xL1n/MOSBius_V2_PCB/README.md

MOSBius V2 PCB Design 
Contains Mother Board & Daughter Board
