xL1n/MOSBius_V2_PCB/MOSbiusPCB_v3b_2025 (pcbway fab correct schematic)/3D/Screenshot 2025-02-14 at 1.38.24 PM.png

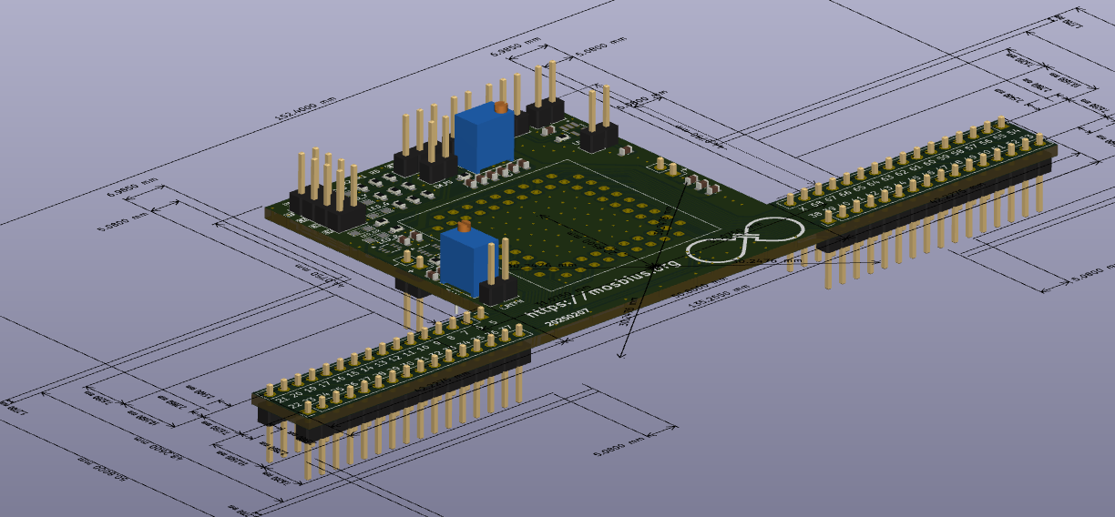
MOSbiusPCB_v3b_2025 (pcbway fab correct schematic)/3D/Screenshot 2025-02-14 at 1.38.24 PM.png
