xL1n/MOSBius_V2_PCB/3314_SMD_25kPOT/3314J-1-253E.step

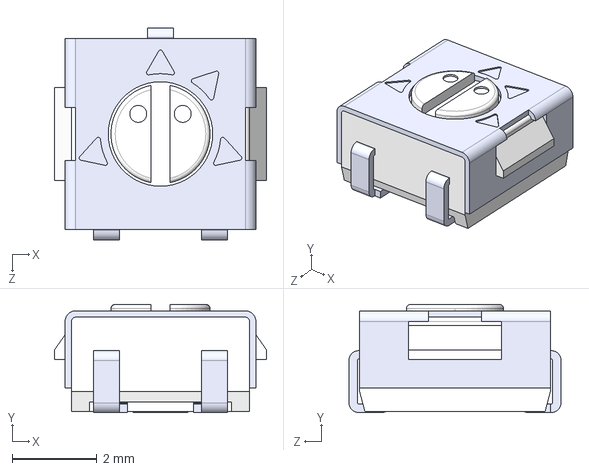
[picture p4: CAD file, 2026-03-12]
3314_SMD_25kPOT/3314J-1-253E.step
5.00 x 2.55 x 5.00 mm
