xL1n/MOSBius_V2_PCB/AD8542ARMZ-REEL/3D/AD8542ARMZ-REEL.stp

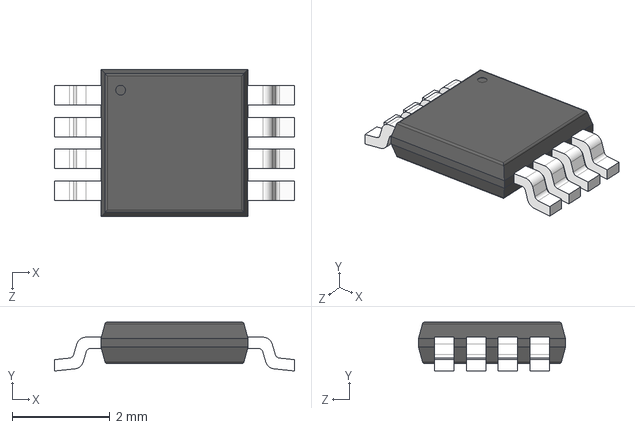
[picture p5: CAD file, 2025-09-01]
AD8542ARMZ-REEL/3D/AD8542ARMZ-REEL.stp
4.90 x 1.00 x 3.00 mm
