xL1n/MOSBius_V2_PCB/combined_board_RPI_pico/combined_board_RPI_pico.step

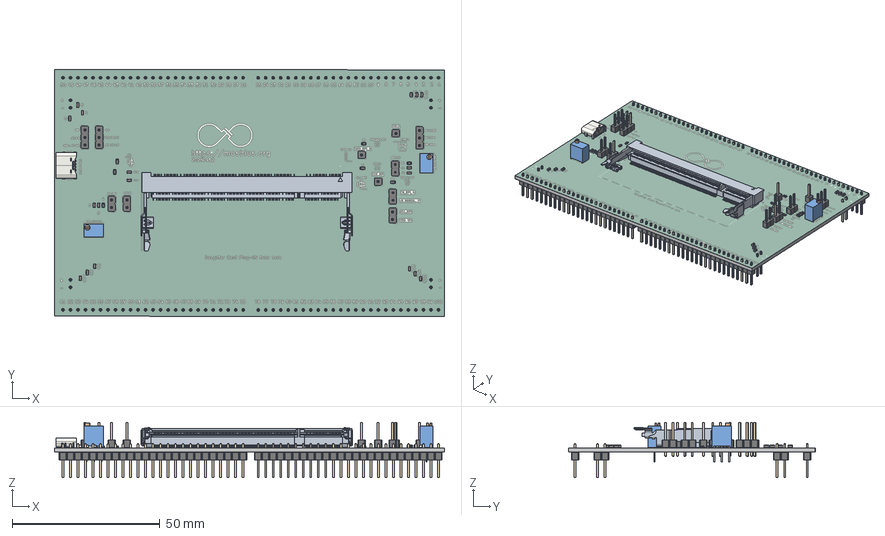
[picture p6: CAD file, 2025-10-16]
combined_board_RPI_pico/combined_board_RPI_pico.step
131.9 x 83.5 x 18.8 mm
R_0603_1608Metric x 7
C_0603_1608Metric x 18
PinHeader_1x03_P2.54mm_Vertical x 3
PinHeader_1x01_P2.54mm_Vertical x 3
PinHeader_1x02_P2.54mm_Vertical x 8
Potentiometer_Bourns_3266Y_Vertical x 2
USB_C_Receptacle_GCT_USB4125-xx-x_6P_TopMnt_Horizontal
PinHeader_1x25_P2.54mm_Vertical x 4
Mother_Card_silkscreen
Mother_Card_soldermask
Mother_Card_PCB
