xL1n/MOSBius_V2_PCB/DS4404_DAC/DS4404N__T_R.step

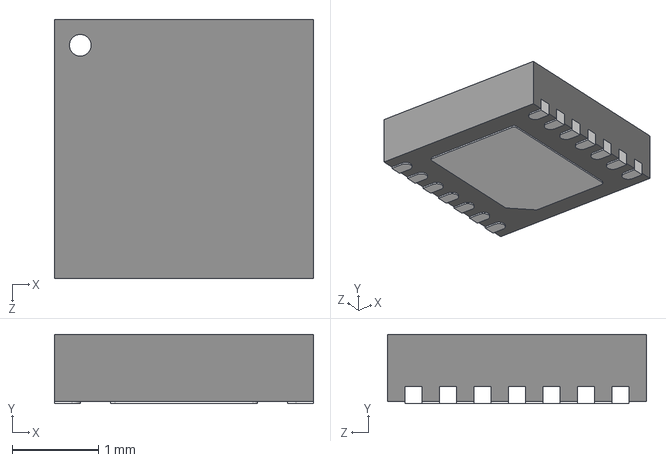
[picture p7: CAD file, 2026-03-12]
DS4404_DAC/DS4404N__T_R.step
3.00 x 0.8 x 3.00 mm
