xL1n/MOSBius_V2_PCB/LTC4365HTS8#PBF/3D/LTC4365HTS8#PBF.stp

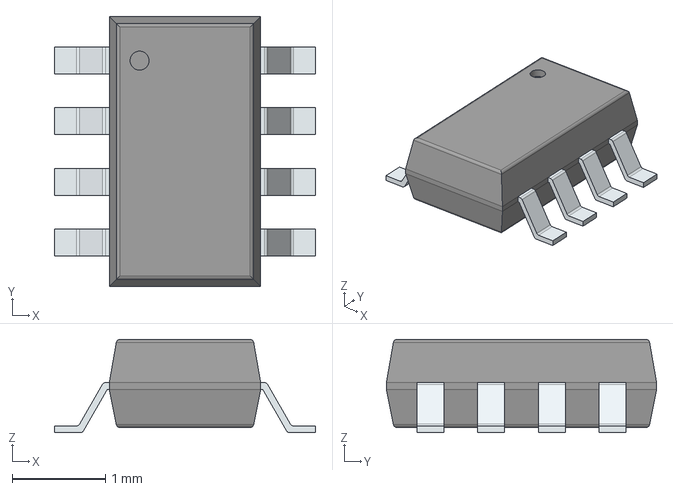
[picture p8: CAD file, 2025-09-01]
LTC4365HTS8#PBF/3D/LTC4365HTS8#PBF.stp
2.80 x 2.90 x 1.00 mm
PinsArrayLR
