xL1n/MOSBius_V2_PCB/MOSbiusPCB_v3b_2025 (pcbway fab correct schematic)/MOSbiusPCB_v3b_2024.step

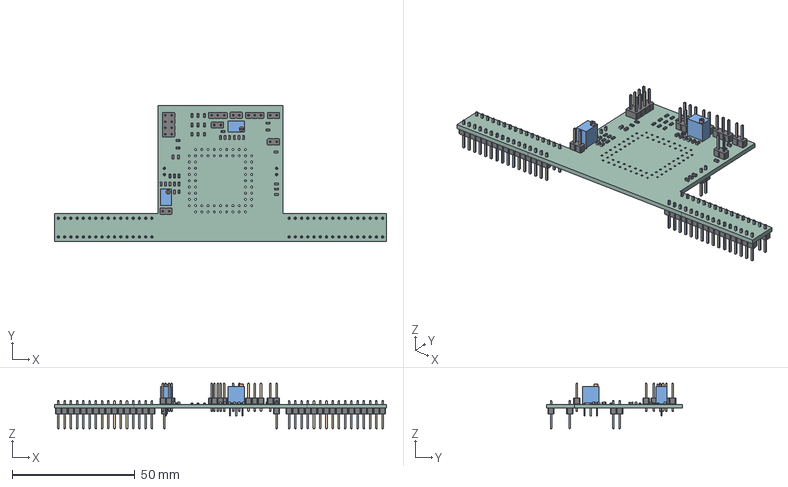
[picture p9: CAD file, 2025-09-01]
MOSbiusPCB_v3b_2025 (pcbway fab correct schematic)/MOSbiusPCB_v3b_2024.step
135.3 x 55.5 x 18.6 mm
C_0603_1608Metric x 18
PinHeader_1x02_P254mm_Vertical x 7
R_0603_1608Metric x 18
Potentiometer_Bourns_3266Y_Vertical x 2
PinHeader_1x16_P254mm_Vertical x 4
PinHeader_1x03_P254mm_Vertical x 2
PinHeader_2x04_P254mm_Vertical
MOSbiusPCB_v3b_2024_PCB
