xL1n/MOSBius_V2_PCB/NCV8164ASN250T1G/3D/NCV8164ASN250T1G.stp

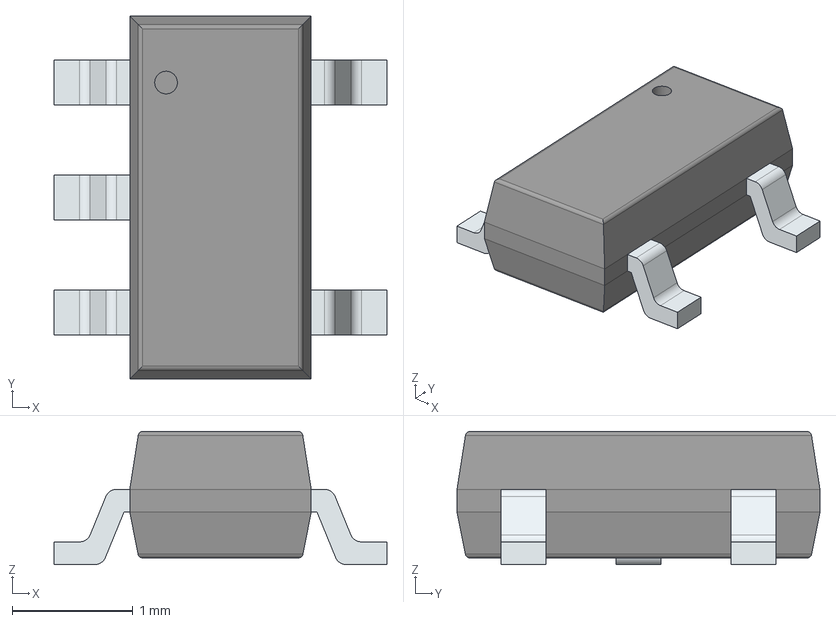
[picture p10: CAD file, 2025-09-01]
NCV8164ASN250T1G/3D/NCV8164ASN250T1G.stp
2.75 x 3.00 x 1.10 mm
PinsArrayL
PinsArrayR
