xL1n/MOSBius_V2_PCB/SN74LVC1G3157DBVR/3D/SN74LVC1G3157DBVR.stp

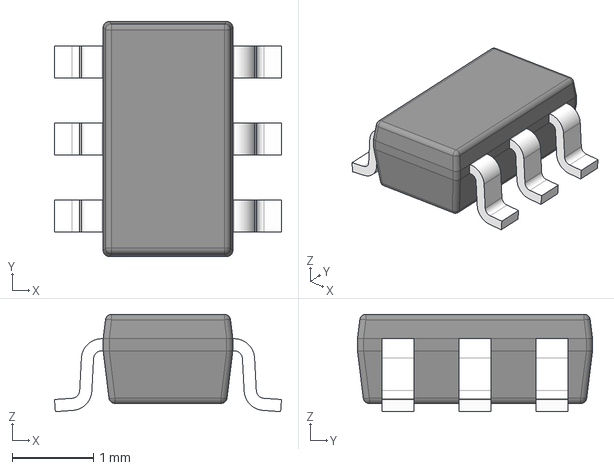
[picture p11: CAD file, 2025-09-01]
SN74LVC1G3157DBVR/3D/SN74LVC1G3157DBVR.stp
2.80 x 2.90 x 1.20 mm
BODY-SOT
LEAD-SOT x 6
