xL1n/MOSBius_V2_PCB/SN74LVC2G241DCUR/3D/SN74LVC2G241DCUR.stp

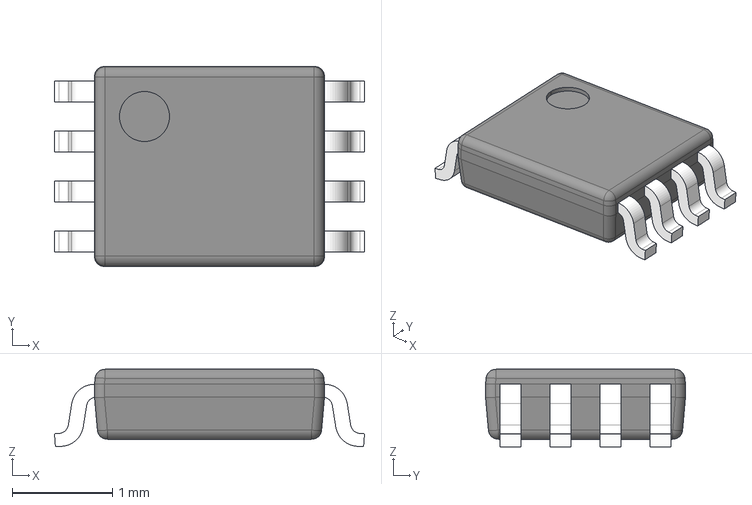
[picture p12: CAD file, 2025-09-01]
SN74LVC2G241DCUR/3D/SN74LVC2G241DCUR.stp
3.10 x 2.00 x 0.775 mm
BODY-VSSOP
LEAD-VSSOP x 8
