xL1n/MOSBius_V2_PCB/UM6K34NTCN/3D/UM6K34NTCN.stp

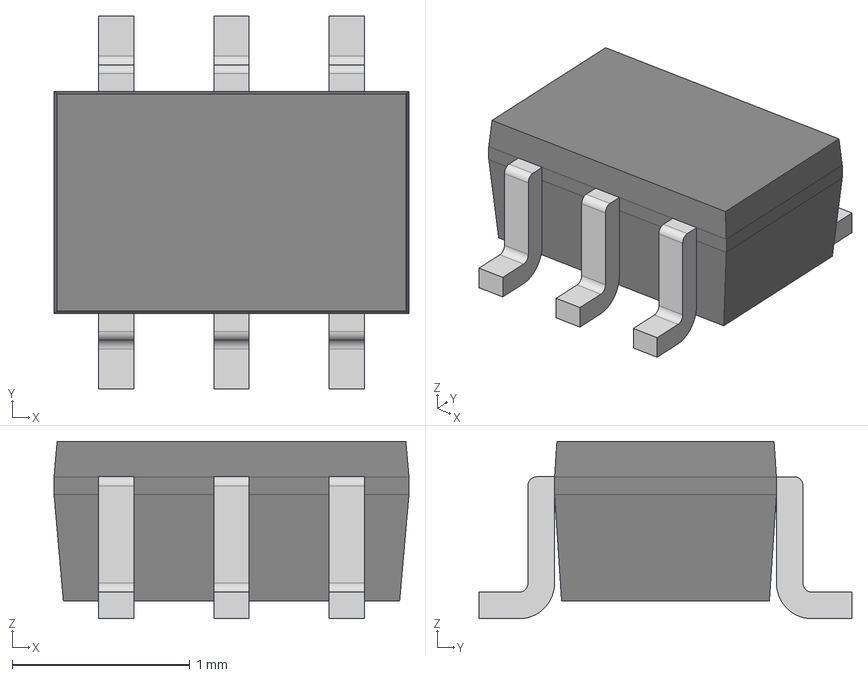
[picture p13: CAD file, 2025-09-01]
UM6K34NTCN/3D/UM6K34NTCN.stp
2.00 x 2.10 x 1 mm
3D_Model_UMT6-prt0
3D_Model_UMT6-prt1
3D_Model_UMT6-prt2
3D_Model_UMT6-prt3
3D_Model_UMT6-prt4
3D_Model_UMT6-prt5
3D_Model_UMT6-prt6
