xL1n/MOSBius_V2_PCB/(list of files, cad)

Other CAD files:
AD8542ARMZ-REEL/Allegro/sop65p490x110-8n.psm
AD8542ARMZ-REEL/DEHDL/ad8542armz_reel/chips/chips.prt
KiCad-RP-Pico-main/SketchUp Model/Pico.skp
LTC4365HTS8#PBF/Allegro/sot65p280x100-8n.psm
LTC4365HTS8#PBF/DEHDL/ltc4365hts8#pbf/chips/chips.prt
MOSbiusPCB_v3b_2025 (pcbway fab correct schematic)/MOSbiusPCB_v3b_2024.stl
NCV8164ASN250T1G/Allegro/sot95p275x110-5n.psm
NCV8164ASN250T1G/DEHDL/ncv8164asn250t1g/chips/chips.prt
SN74LVC1G3157DBVR/Allegro/sot95p280x145-6n.psm
SN74LVC1G3157DBVR/DEHDL/sn74lvc1g3157dbvr/chips/chips.prt
SN74LVC2G241DCUR/Allegro/sop50p310x90-8n.psm
SN74LVC2G241DCUR/DEHDL/sn74lvc2g241dcur/chips/chips.prt
SN74LVC2G34DBVR/Allegro/sot95p280x145-6n.psm
SN74LVC2G34DBVR/DEHDL/sn74lvc2g34dbvr/chips/chips.prt
SODIIMM_200_Socket/Allegro/517465304.psm
SODIIMM_200_Socket/DEHDL/5_1746530_4/chips/chips.prt
UM6K34NTCN/Allegro/sot65p210x100-6n.psm
UM6K34NTCN/DEHDL/um6k34ntcn/chips/chips.prt
