xL1n/MOSBius_V2_PCB/(list of files, drawings)

Other design files:
AD8542ARMZ-REEL/Altium/AD8542ARMZ-REEL.SchLib
AD8542ARMZ-REEL/Altium/SOP65P490X110-8N.PcbLib
LTC4365HTS8#PBF/Altium/LTC4365HTS8#PBF.SchLib
LTC4365HTS8#PBF/Altium/SOT65P280X100-8N.PcbLib
MOSbius_V2_Test/V2_TST/freerouting.dsn
MOSbius_V2_Test/V2_TST/temp-freerouting.dsn
NCV8164ASN250T1G/Altium/NCV8164ASN250T1G.SchLib
NCV8164ASN250T1G/Altium/SOT95P275X110-5N.PcbLib
SN74LVC1G3157DBVR/Altium/SN74LVC1G3157DBVR.SchLib
SN74LVC1G3157DBVR/Altium/SOT95P280X145-6N.PcbLib
SN74LVC2G34DBVR/Altium/SN74LVC2G34DBVR.SchLib
SN74LVC2G34DBVR/Altium/SOT95P280X145-6N.PcbLib
SN74LVC2G241DCUR/Altium/SN74LVC2G241DCUR.SchLib
SN74LVC2G241DCUR/Altium/SOP50P310X90-8N.PcbLib
SODIIMM_200_Socket/Altium/5-1746530-4.SchLib
SODIIMM_200_Socket/Altium/517465304.PcbLib
UM6K34NTCN/Altium/SOT65P210X100-6N.PcbLib
UM6K34NTCN/Altium/UM6K34NTCN.SchLib
