xL1n/MOSBius_V2_PCB/combined_board/combined_board.kicad_pcb

## KiCad design combined_board/combined_board.kicad_pcb (2026-03-12)

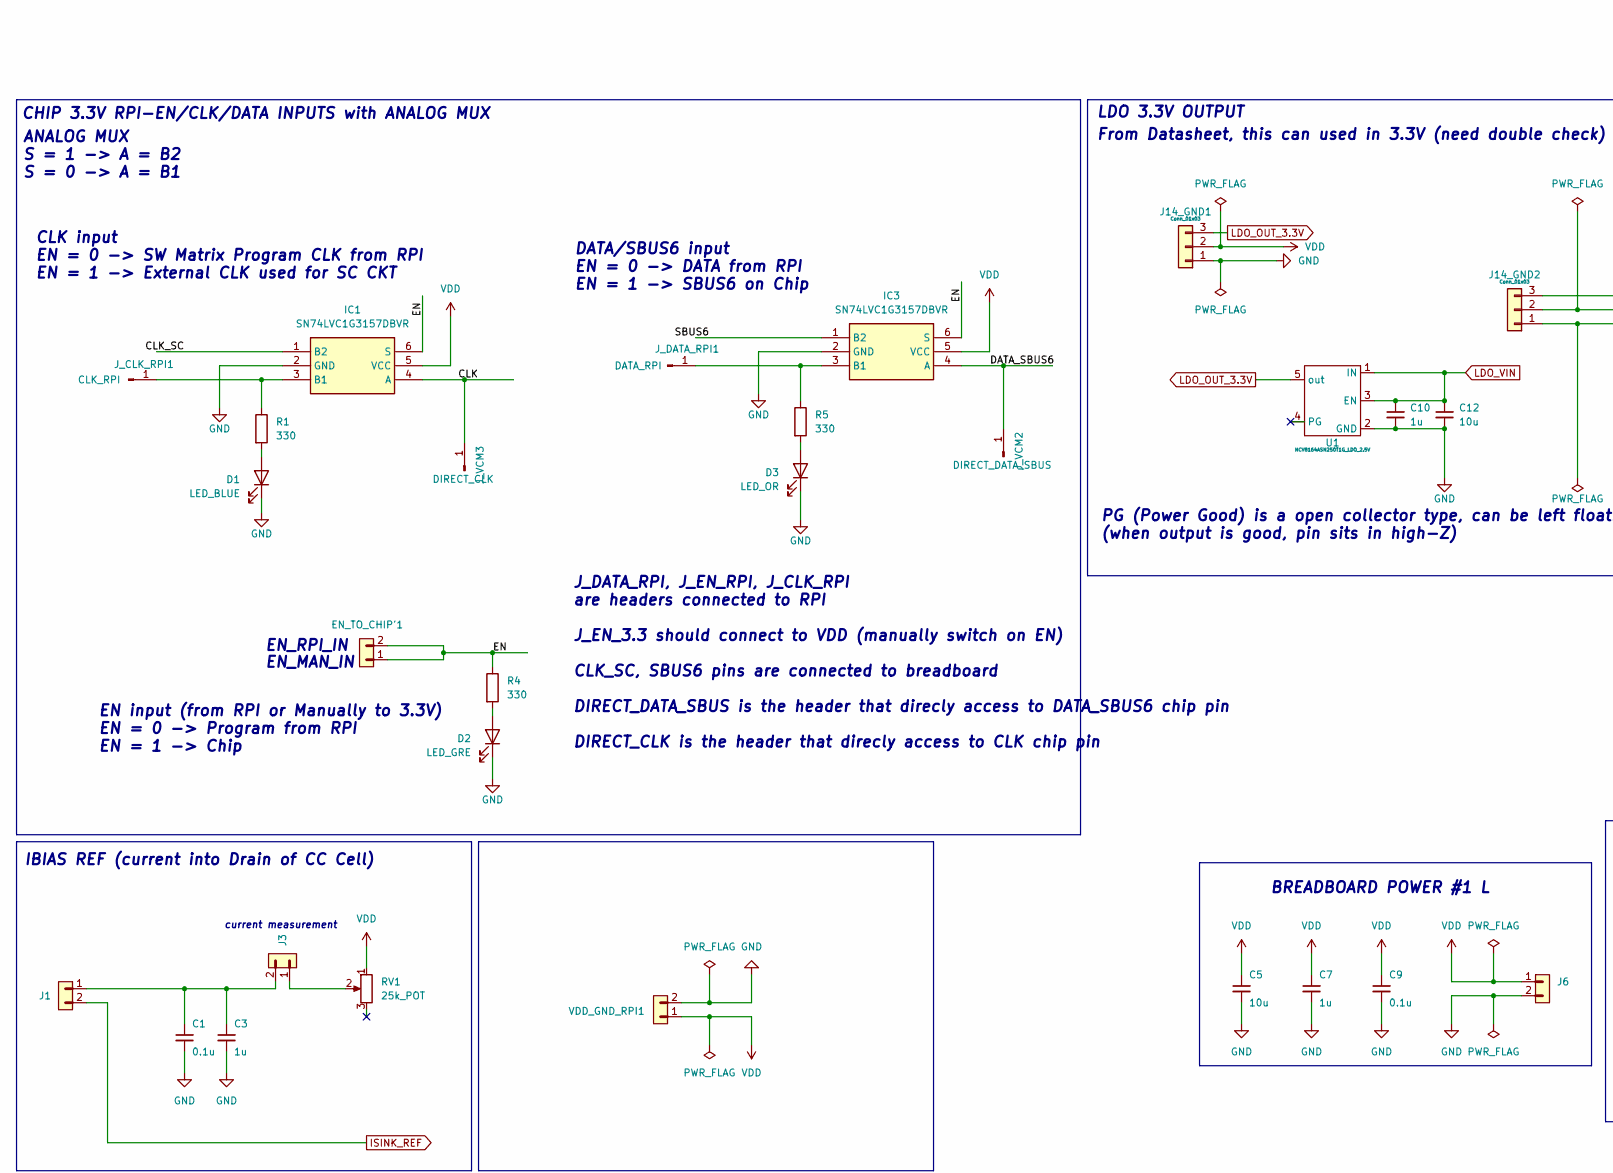
[picture p27: schematic combined_board.kicad_sch, MOSBius_V2 PCB Mother Card Schematic, part in row 1, column 1]

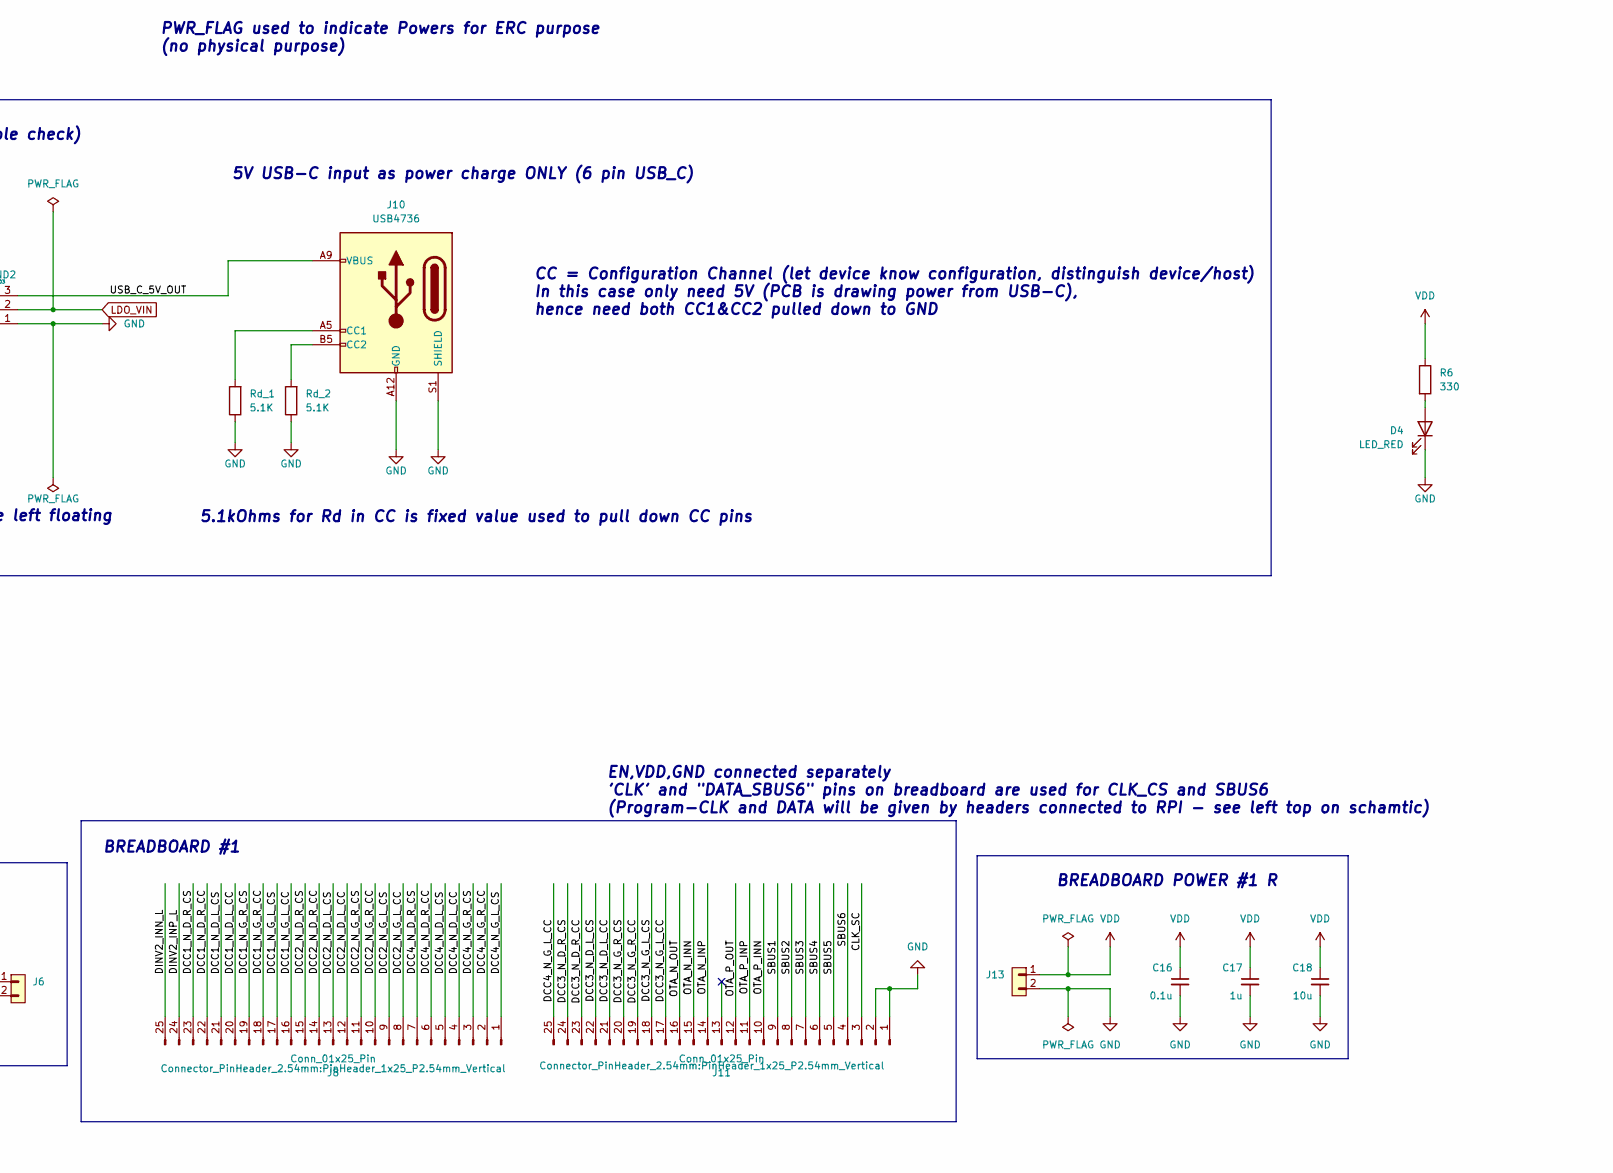
[picture p28: schematic combined_board.kicad_sch, MOSBius_V2 PCB Mother Card Schematic, part in row 1, column 2]

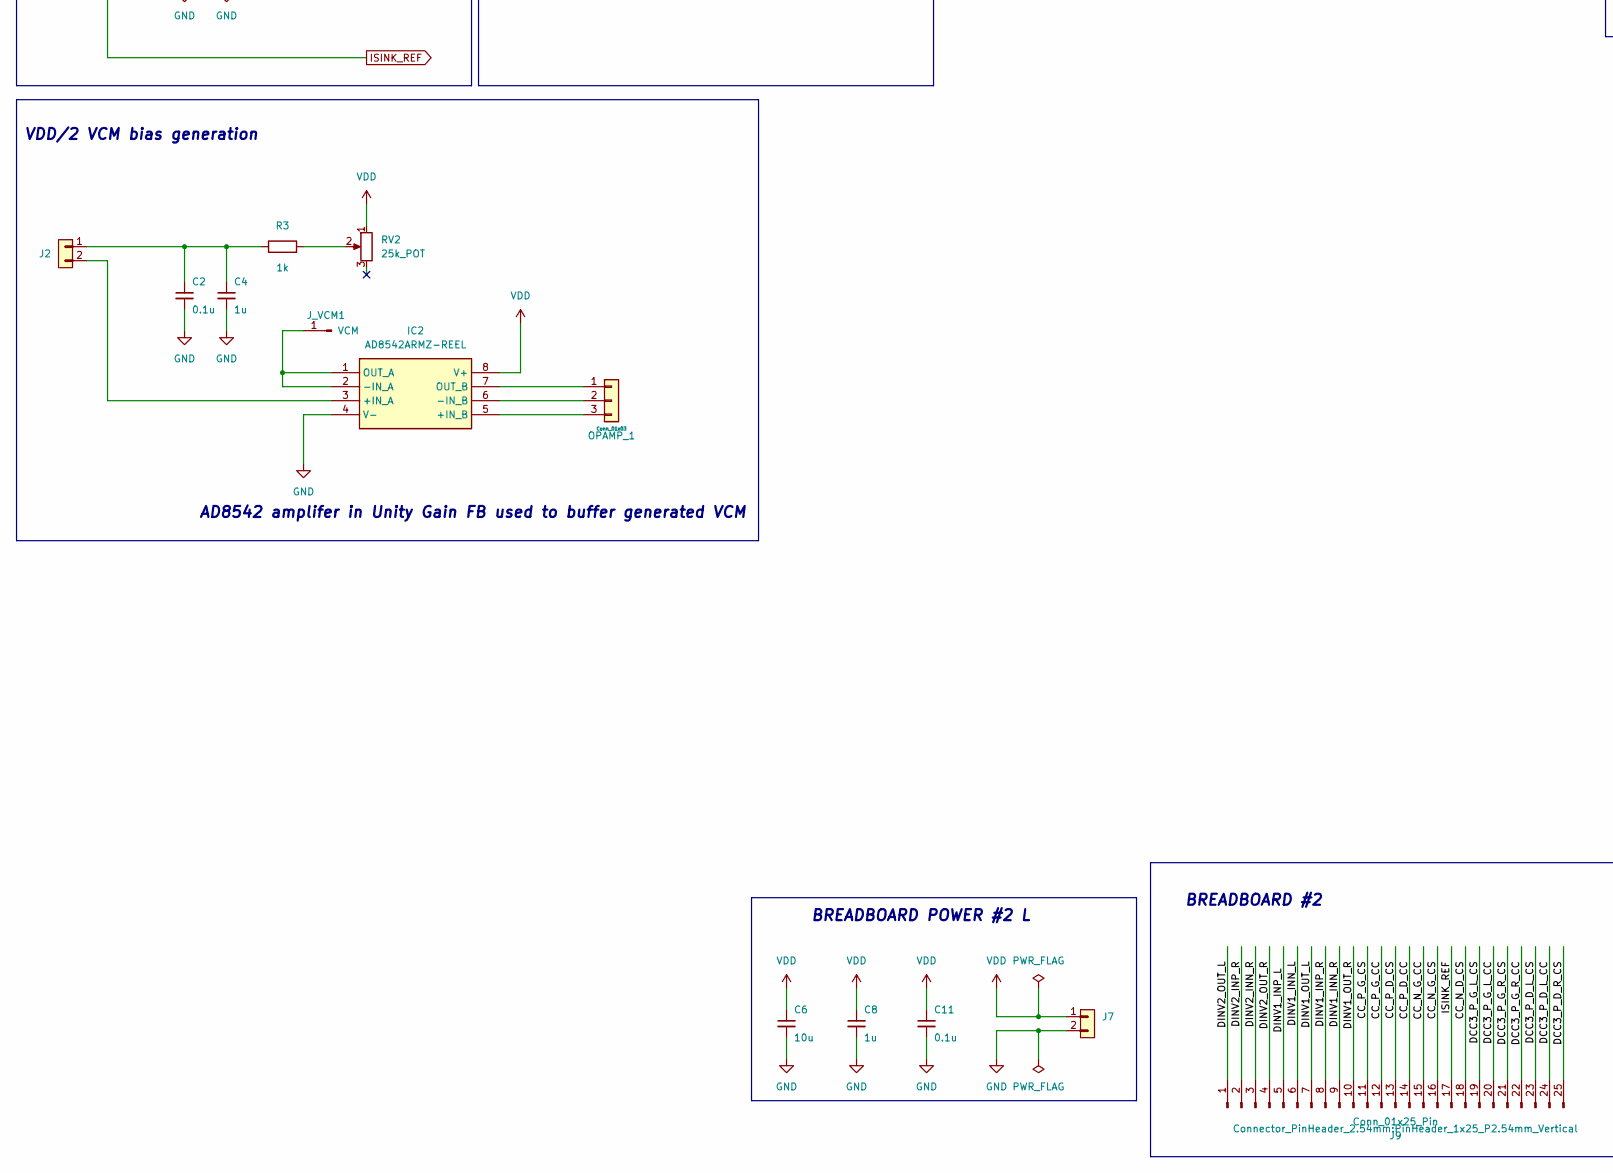
[picture p29: schematic combined_board.kicad_sch, MOSBius_V2 PCB Mother Card Schematic, part in row 2, column 1]

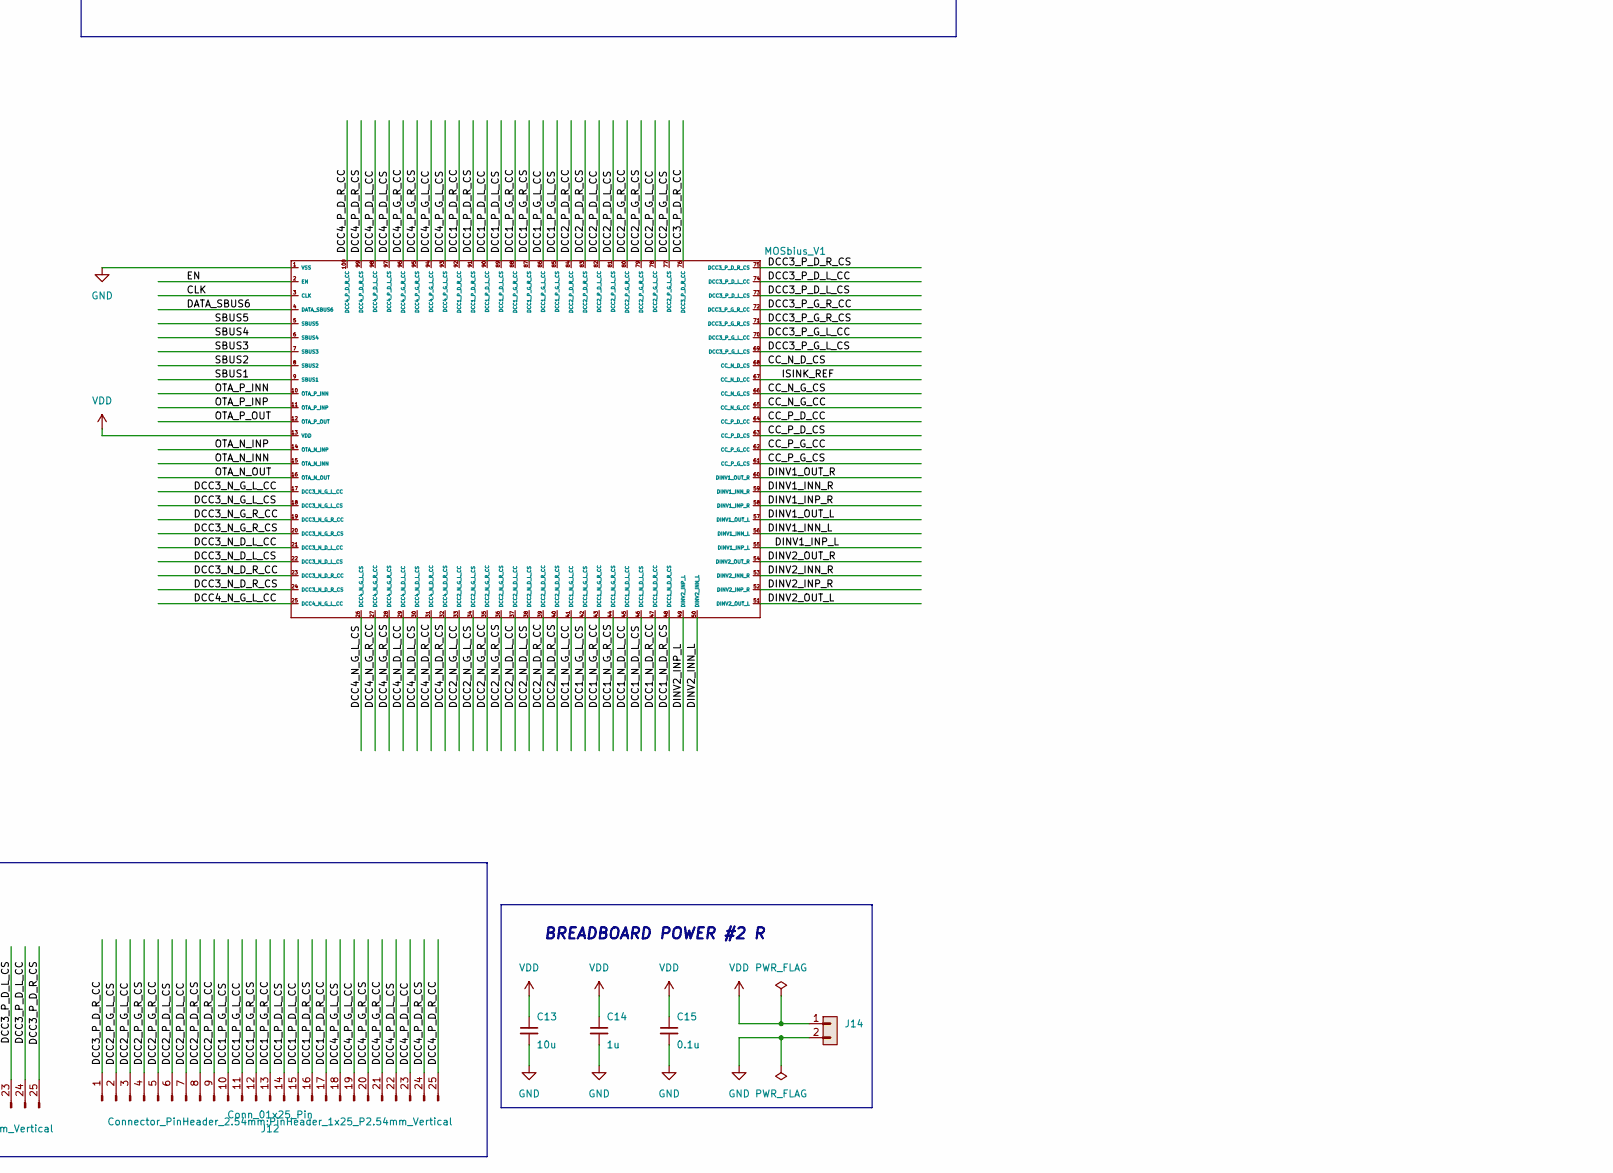
[picture p30: schematic combined_board.kicad_sch, MOSBius_V2 PCB Mother Card Schematic, part in row 2, column 2]

Parts:
C1, C2, C9, C11, C15, C16: 0.1u; C_0603_1608Metric
C3, C4, C7, C8, C10, C14, C17: 1u; C_0603_1608Metric
C5, C6, C12, C13, C18: 10u; C_0603_1608Metric
D1: LED_BLUE; LED_150120RS75000_WRE
D2: LED_GRE; LED_150120RS75000_WRE
D3: LED_OR; LED_150120RS75000_WRE
D4: LED_RED; LED_150120RS75000_WRE
EN_TO_CHIP'1: PINHD_1x2_Male; PinHeader_1x02_P2.54mm_Vertical
IC1, IC3: SN74LVC1G3157DBVR; SN74LVC1G3157; Manufacturer_Part_Number SN74LVC1G3157DBVR; Mouser Part Number 595-SN74LVC1G3157DBV
IC2: AD8542ARMZ-REEL; AD8542; Manufacturer_Part_Number AD8542ARMZ-REEL; Mouser Part Number 584-AD8542ARMZ-R
J1, J2, J3, J6, J7, J14: PINHD_1x2_Male; PinHeader_1x02_P2.54mm_Vertical
J8, J9, J11, J12: Conn_01x25_Pin; PinHeader_1x25_P2.54mm_Vertical
J10: USB4736; USB_C_Receptacle_GCT_USB4125-xx-x_6P_TopMnt_Horizontal
J13: Conn_01x02_Pin; PinHeader_1x02_P2.54mm_Vertical
J14_GND1, J14_GND2: Conn_01x03; PinHeader_1x03_P2.54mm_Vertical
J_CLK_RPI1: CLK_RPI; PinHeader_1x01_P2.54mm_Vertical
J_DATA_RPI1: DATA_RPI; PinHeader_1x01_P2.54mm_Vertical
J_VCM1: VCM; PinHeader_1x01_P2.54mm_Vertical
J_VCM2: DIRECT_DATA_SBUS; PinHeader_1x01_P2.54mm_Vertical
J_VCM3: DIRECT_CLK; PinHeader_1x01_P2.54mm_Vertical
MOSbius_V1: MOSbius_V2; ArtInChip_QFN-100-1EP_12x12mm_P0.4mm_EP7.4x7.4mm
OPAMP_1: Conn_01x03; PinHeader_1x03_P2.54mm_Vertical
R1, R4, R5, R6: 330; R_0603_1608Metric
R3: 1k; R_0603_1608Metric
RV1, RV2: 25k_POT; Potentiometer_Bourns_3266Y_Vertical
Rd_1, Rd_2: 5.1K; R_0603_1608Metric
U1: NCV8164ASN250T1G_LDO_2.5V; NCV8164ASN250T1G_LDO
VDD_GND_RPI1: PINHD_1x2_Male; PinHeader_1x02_P2.54mm_Vertical

Connections:
/CC_N_D_CS: J9.18, MOSbius_V1.68 (CC_N_D_CS); also elsewhere on the board
/CC_N_G_CC: J9.15, MOSbius_V1.65 (CC_N_G_CC); also elsewhere on the board
/CC_N_G_CS: J9.16, MOSbius_V1.66 (CC_N_G_CS); also elsewhere on the board
/CC_P_D_CC: J9.14, MOSbius_V1.64 (CC_P_D_CC); also elsewhere on the board
/CC_P_D_CS: J9.13, MOSbius_V1.63 (CC_P_D_CS); also elsewhere on the board
/CC_P_G_CC: J9.12, MOSbius_V1.62 (CC_P_G_CC); also elsewhere on the board
/CC_P_G_CS: J9.11, MOSbius_V1.61 (CC_P_G_CS); also elsewhere on the board
/CLK: IC1.4 (A), J_VCM3.1, MOSbius_V1.3 (CLK); also elsewhere on the board
/CLK_SC: IC1.1 (B2), J11.3
/DATA_SBUS6: IC3.4 (A), J_VCM2.1, MOSbius_V1.4 (DATA_SBUS6); also elsewhere on the board
/DCC1_N_D_L_CC: J8.20, MOSbius_V1.45 (DCC1_N_D_L_CC); also elsewhere on the board
/DCC1_N_D_L_CS: J8.21, MOSbius_V1.46 (DCC1_N_D_L_CS); also elsewhere on the board
/DCC1_N_D_R_CC: J8.22, MOSbius_V1.47 (DCC1_N_D_R_CC); also elsewhere on the board
/DCC1_N_D_R_CS: J8.23, MOSbius_V1.48 (DCC1_N_D_R_CS); also elsewhere on the board
/DCC1_N_G_L_CC: J8.16, MOSbius_V1.41 (DCC1_N_G_L_CC); also elsewhere on the board
/DCC1_N_G_L_CS: J8.17, MOSbius_V1.42 (DCC1_N_G_L_CS); also elsewhere on the board
/DCC1_N_G_R_CC: J8.18, MOSbius_V1.43 (DCC1_N_G_R_CC); also elsewhere on the board
/DCC1_N_G_R_CS: J8.19, MOSbius_V1.44 (DCC1_N_G_R_CS); also elsewhere on the board
/DCC1_P_D_L_CC: J12.15, MOSbius_V1.90 (DCC1_P_D_L_CC); also elsewhere on the board
/DCC1_P_D_L_CS: J12.14, MOSbius_V1.89 (DCC1_P_D_L_CS); also elsewhere on the board
/DCC1_P_D_R_CC: J12.17, MOSbius_V1.92 (DCC1_P_D_R_CC); also elsewhere on the board
/DCC1_P_D_R_CS: J12.16, MOSbius_V1.91 (DCC1_P_D_R_CS); also elsewhere on the board
/DCC1_P_G_L_CC: J12.11, MOSbius_V1.86 (DCC1_P_G_L_CC); also elsewhere on the board
/DCC1_P_G_L_CS: J12.10, MOSbius_V1.85 (DCC1_P_G_L_CS); also elsewhere on the board
/DCC1_P_G_R_CC: J12.13, MOSbius_V1.88 (DCC1_P_G_R_CC); also elsewhere on the board
/DCC1_P_G_R_CS: J12.12, MOSbius_V1.87 (DCC1_P_G_R_CS); also elsewhere on the board
/DCC2_N_D_L_CC: J8.12, MOSbius_V1.37 (DCC2_N_D_L_CC); also elsewhere on the board
/DCC2_N_D_L_CS: J8.13, MOSbius_V1.38 (DCC2_N_D_L_CS); also elsewhere on the board
/DCC2_N_D_R_CC: J8.14, MOSbius_V1.39 (DCC2_N_D_R_CC); also elsewhere on the board
/DCC2_N_D_R_CS: J8.15, MOSbius_V1.40 (DCC2_N_D_R_CS); also elsewhere on the board
/DCC2_N_G_L_CC: J8.8, MOSbius_V1.33 (DCC2_N_G_L_CC); also elsewhere on the board
/DCC2_N_G_L_CS: J8.9, MOSbius_V1.34 (DCC2_N_G_L_CS); also elsewhere on the board
/DCC2_N_G_R_CC: J8.10, MOSbius_V1.35 (DCC2_N_G_R_CC); also elsewhere on the board
/DCC2_N_G_R_CS: J8.11, MOSbius_V1.36 (DCC2_N_G_R_CS); also elsewhere on the board
/DCC2_P_D_L_CC: J12.7, MOSbius_V1.82 (DCC2_P_D_L_CC); also elsewhere on the board
/DCC2_P_D_L_CS: J12.6, MOSbius_V1.81 (DCC2_P_D_L_CS); also elsewhere on the board
/DCC2_P_D_R_CC: J12.9, MOSbius_V1.84 (DCC2_P_D_R_CC); also elsewhere on the board
/DCC2_P_D_R_CS: J12.8, MOSbius_V1.83 (DCC2_P_D_R_CS); also elsewhere on the board
/DCC2_P_G_L_CC: J12.3, MOSbius_V1.78 (DCC2_P_G_L_CC); also elsewhere on the board
/DCC2_P_G_L_CS: J12.2, MOSbius_V1.77 (DCC2_P_G_L_CS); also elsewhere on the board
/DCC2_P_G_R_CC: J12.5, MOSbius_V1.80 (DCC2_P_G_R_CC); also elsewhere on the board
/DCC2_P_G_R_CS: J12.4, MOSbius_V1.79 (DCC2_P_G_R_CS); also elsewhere on the board
/DCC3_N_D_L_CC: J11.21, MOSbius_V1.21 (DCC3_N_D_L_CC); also elsewhere on the board
/DCC3_N_D_L_CS: J11.22, MOSbius_V1.22 (DCC3_N_D_L_CS); also elsewhere on the board
/DCC3_N_D_R_CC: J11.23, MOSbius_V1.23 (DCC3_N_D_R_CC); also elsewhere on the board
/DCC3_N_D_R_CS: J11.24, MOSbius_V1.24 (DCC3_N_D_R_CS); also elsewhere on the board
/DCC3_N_G_L_CC: J11.17, MOSbius_V1.17 (DCC3_N_G_L_CC); also elsewhere on the board
/DCC3_N_G_L_CS: J11.18, MOSbius_V1.18 (DCC3_N_G_L_CS); also elsewhere on the board
/DCC3_N_G_R_CC: J11.19, MOSbius_V1.19 (DCC3_N_G_R_CC); also elsewhere on the board
/DCC3_N_G_R_CS: J11.20, MOSbius_V1.20 (DCC3_N_G_R_CS); also elsewhere on the board
/DCC3_P_D_L_CC: J9.24, MOSbius_V1.74 (DCC3_P_D_L_CC); also elsewhere on the board
/DCC3_P_D_L_CS: J9.23, MOSbius_V1.73 (DCC3_P_D_L_CS); also elsewhere on the board
/DCC3_P_D_R_CC: J12.1, MOSbius_V1.76 (DCC3_P_D_R_CC); also elsewhere on the board
/DCC3_P_D_R_CS: J9.25, MOSbius_V1.75 (DCC3_P_D_R_CS); also elsewhere on the board
/DCC3_P_G_L_CC: J9.20, MOSbius_V1.70 (DCC3_P_G_L_CC); also elsewhere on the board
/DCC3_P_G_L_CS: J9.19, MOSbius_V1.69 (DCC3_P_G_L_CS); also elsewhere on the board
/DCC3_P_G_R_CC: J9.22, MOSbius_V1.72 (DCC3_P_G_R_CC); also elsewhere on the board
/DCC3_P_G_R_CS: J9.21, MOSbius_V1.71 (DCC3_P_G_R_CS); also elsewhere on the board
/DCC4_N_D_L_CC: J8.4, MOSbius_V1.29 (DCC4_N_D_L_CC); also elsewhere on the board
/DCC4_N_D_L_CS: J8.5, MOSbius_V1.30 (DCC4_N_D_L_CS); also elsewhere on the board
/DCC4_N_D_R_CC: J8.6, MOSbius_V1.31 (DCC4_N_D_R_CC); also elsewhere on the board
/DCC4_N_D_R_CS: J8.7, MOSbius_V1.32 (DCC4_N_D_R_CS); also elsewhere on the board
/DCC4_N_G_L_CC: J11.25, MOSbius_V1.25 (DCC4_N_G_L_CC); also elsewhere on the board
/DCC4_N_G_L_CS: J8.1, MOSbius_V1.26 (DCC4_N_G_L_CS); also elsewhere on the board
/DCC4_N_G_R_CC: J8.2, MOSbius_V1.27 (DCC4_N_G_R_CC); also elsewhere on the board
/DCC4_N_G_R_CS: J8.3, MOSbius_V1.28 (DCC4_N_G_R_CS); also elsewhere on the board
/DCC4_P_D_L_CC: J12.23, MOSbius_V1.98 (DCC4_P_D_L_CC); also elsewhere on the board
/DCC4_P_D_L_CS: J12.22, MOSbius_V1.97 (DCC4_P_D_L_CS); also elsewhere on the board
/DCC4_P_D_R_CC: J12.25, MOSbius_V1.100 (DCC4_P_D_R_CC); also elsewhere on the board
/DCC4_P_D_R_CS: J12.24, MOSbius_V1.99 (DCC4_P_D_R_CS); also elsewhere on the board
/DCC4_P_G_L_CC: J12.19, MOSbius_V1.94 (DCC4_P_G_L_CC); also elsewhere on the board
/DCC4_P_G_L_CS: J12.18, MOSbius_V1.93 (DCC4_P_G_L_CS); also elsewhere on the board
/DCC4_P_G_R_CC: J12.21, MOSbius_V1.96 (DCC4_P_G_R_CC); also elsewhere on the board
/DCC4_P_G_R_CS: J12.20, MOSbius_V1.95 (DCC4_P_G_R_CS); also elsewhere on the board
/DINV1_INN_L: J9.6, MOSbius_V1.56 (DINV1_INN_L); also elsewhere on the board
/DINV1_INN_R: J9.9, MOSbius_V1.59 (DINV1_INN_R); also elsewhere on the board
/DINV1_INP_L: J9.5, MOSbius_V1.55 (DINV1_INP_L); also elsewhere on the board
/DINV1_INP_R: J9.8, MOSbius_V1.58 (DINV1_INP_R); also elsewhere on the board
/DINV1_OUT_L: J9.7, MOSbius_V1.57 (DINV1_OUT_L); also elsewhere on the board
/DINV1_OUT_R: J9.10, MOSbius_V1.60 (DINV1_OUT_R); also elsewhere on the board
/DINV2_INN_L: J8.25, MOSbius_V1.50 (DINV2_INN_L); also elsewhere on the board
/DINV2_INN_R: J9.3, MOSbius_V1.53 (DINV2_INN_R); also elsewhere on the board
/DINV2_INP_L: J8.24, MOSbius_V1.49 (DINV2_INP_L); also elsewhere on the board
/DINV2_INP_R: J9.2, MOSbius_V1.52 (DINV2_INP_R); also elsewhere on the board
/DINV2_OUT_L: J9.1, MOSbius_V1.51 (DINV2_OUT_L); also elsewhere on the board
/DINV2_OUT_R: J9.4, MOSbius_V1.54 (DINV2_OUT_R); also elsewhere on the board
/EN: EN_TO_CHIP'1.1, EN_TO_CHIP'1.2, IC1.6 (S), IC3.6 (S), MOSbius_V1.2 (EN), R4.1; also elsewhere on the board
/OTA_N_INN: J11.15, MOSbius_V1.15 (OTA_N_INN); also elsewhere on the board
/OTA_N_INP: J11.14, MOSbius_V1.14 (OTA_N_INP); also elsewhere on the board
/OTA_N_OUT: J11.16, MOSbius_V1.16 (OTA_N_OUT); also elsewhere on the board
/OTA_P_INN: J11.10, MOSbius_V1.10 (OTA_P_INN); also elsewhere on the board
/OTA_P_INP: J11.11, MOSbius_V1.11 (OTA_P_INP); also elsewhere on the board
/OTA_P_OUT: J11.12, MOSbius_V1.12 (OTA_P_OUT); also elsewhere on the board
/SBUS1: J11.9, MOSbius_V1.9 (SBUS1); also elsewhere on the board
/SBUS2: J11.8, MOSbius_V1.8 (SBUS2); also elsewhere on the board
/SBUS3: J11.7, MOSbius_V1.7 (SBUS3); also elsewhere on the board
/SBUS4: J11.6, MOSbius_V1.6 (SBUS4); also elsewhere on the board
/SBUS5: J11.5, MOSbius_V1.5 (SBUS5); also elsewhere on the board
/SBUS6: IC3.1 (B2), J11.4
/USB_C_5V_OUT: J10.A9 (VBUS), J10.B9 (VBUS), J14_GND2.3
GND: C1.2, C2.2, C3.2, C4.2, C5.2, C6.2, C7.2, C8.2, C9.2, C10.2, C11.2, C12.2, C13.2, C14.2, C15.2, C16.2, C17.2, C18.2, D1.1 (K), D2.1 (K), D3.1 (K), D4.1 (K), IC1.2 (GND), IC2.4 (V-), IC3.2 (GND), J6.2, J7.2, J10.A12 (GND), J10.B12 (GND), J10.S1 (SHIELD), J11.1, J11.2, J13.2, J14.2, J14_GND1.1, J14_GND2.1, MOSbius_V1.1 (VSS), Rd_1.1, Rd_2.1, U1.2 (GND), VDD_GND_RPI1.2; also elsewhere on the board
ISINK_REF: J1.2, J9.17, MOSbius_V1.67 (CC_N_D_CC); also elsewhere on the board
LDO_OUT_3.3V: J14_GND1.3, U1.5 (out)
LDO_VIN: C10.1, C12.1, J14_GND2.2, U1.1 (IN), U1.3 (EN)
unnamed: C1.1, C3.1, J1.1, J3.2
unnamed: C2.1, C4.1, J2.1, R3.2
unnamed: D1.2 (A), R1.2
unnamed: D2.2 (A), R4.2
unnamed: D3.2 (A), R5.2
unnamed: D4.2 (A), R6.2
unnamed: IC1.3 (B1), J_CLK_RPI1.1, R1.1
unnamed: IC2.3 (+IN_A), J2.2
unnamed: IC2.5 (+IN_B), OPAMP_1.3
unnamed: IC2.1 (OUT_A), IC2.2 (-IN_A), J_VCM1.1
unnamed: IC2.6 (-IN_B), OPAMP_1.2
unnamed: IC2.7 (OUT_B), OPAMP_1.1
unnamed: IC3.3 (B1), J_DATA_RPI1.1, R5.1
unnamed: J3.1, RV1.2
unnamed: J10.A5 (CC1), Rd_1.2
unnamed: J10.B5 (CC2), Rd_2.2
unnamed: R3.1, RV2.2
VDD: C5.1, C6.1, C7.1, C8.1, C9.1, C11.1, C13.1, C14.1, C15.1, C16.1, C17.1, C18.1, IC1.5 (VCC), IC2.8 (V+), IC3.5 (VCC), J6.1, J7.1, J13.1, J14.1, J14_GND1.2, MOSbius_V1.13 (VDD), R6.1, RV1.1, RV2.1, VDD_GND_RPI1.1; also elsewhere on the board

Notes on the sheet:
BREADBOARD #2
LDO 3.3V OUTPUT
BREADBOARD POWER #2 R
CLK input EN = 0 -> SW Matrix Program CLK from RPI EN = 1 -> External CLK used for SC CKT
CC = Configuration Channel (let device know configuration, distinguish device/host) In this case only need 5V (PCB is drawing power from USB-C), hence need both CC1&CC2 pulled down to GND
EN_RPI_IN
AD8542 amplifer in Unity Gain FB used to buffer generated VCM
PWR_FLAG used to indicate Powers for ERC purpose (no physical purpose)
BREADBOARD #1
IBIAS REF (current into Drain of CC Cell)
BREADBOARD POWER #1 R
From Datasheet, this can used in 3.3V (need double check)
EN_MAN_IN
EN,VDD,GND connected separately 'CLK' and "DATA_SBUS6" pins on breadboard are used for CLK_CS and SBUS6 (Program-CLK and DATA will be given by headers connected to RPI - see left top on schamtic)
5V USB-C input as power charge ONLY (6 pin USB_C)
ANALOG MUX S = 1 -> A = B2 S = 0 -> A = B1
VDD/2 VCM bias generation
EN input (from RPI or Manually to 3.3V) EN = 0 -> Program from RPI EN = 1 -> Chip
J_DATA_RPI, J_EN_RPI, J_CLK_RPI are headers connected to RPI J_EN_3.3 should connect to VDD (manually switch on EN) CLK_SC, SBUS6 pins are connected to breadboard DIRECT_DATA_SBUS is the header that direcly access to DATA_SBUS6 chip pin DIRECT_CLK is the header that direcly access to CLK chip pin
BREADBOARD POWER #2 L
CHIP 3.3V RPI-EN/CLK/DATA INPUTS with ANALOG MUX
DATA/SBUS6 input EN = 0 -> DATA from RPI EN = 1 -> SBUS6 on Chip
BREADBOARD POWER #1 L
5.1kOhms for Rd in CC is fixed value used to pull down CC pins
current measurement
PG (Power Good) is a open collector type, can be left floating (when output is good, pin sits in high-Z)

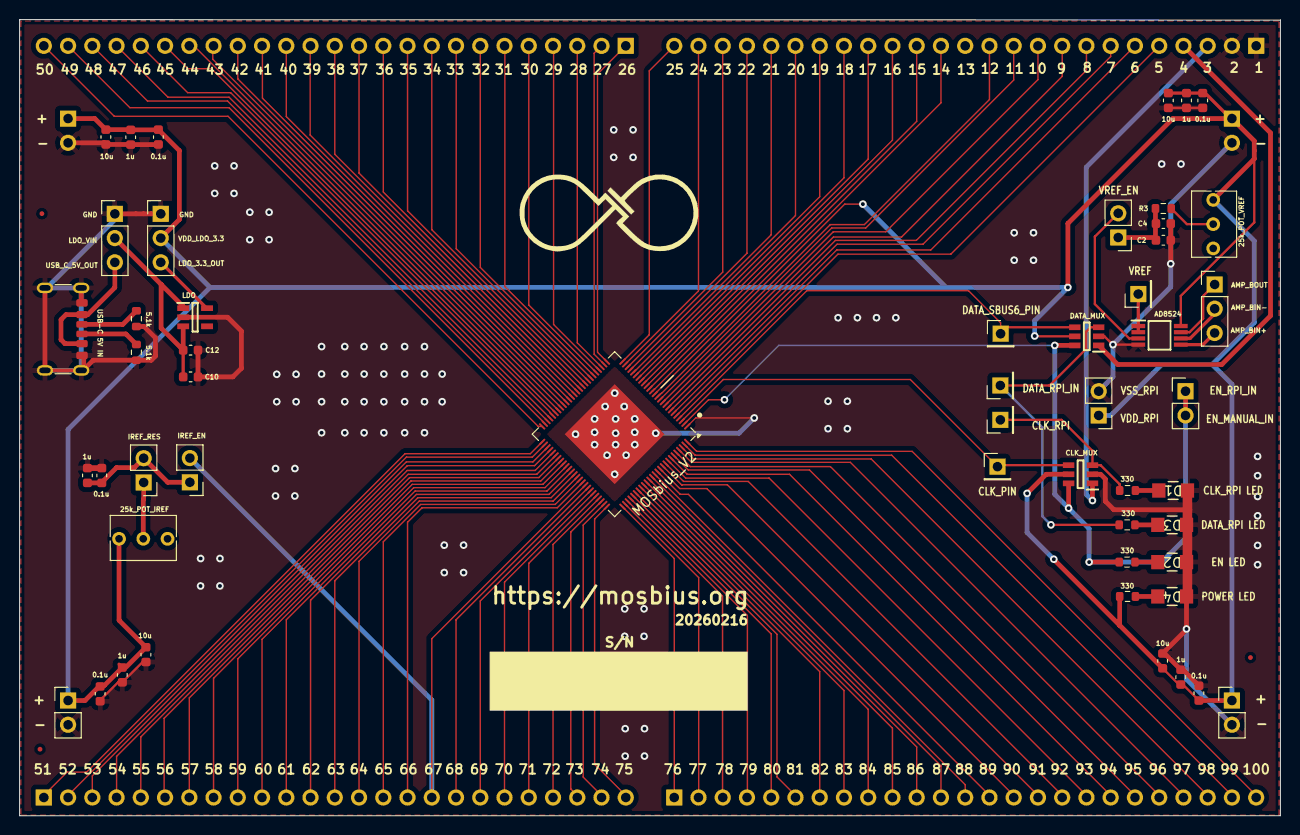
[picture p31: board combined_board.kicad_pcb from above]

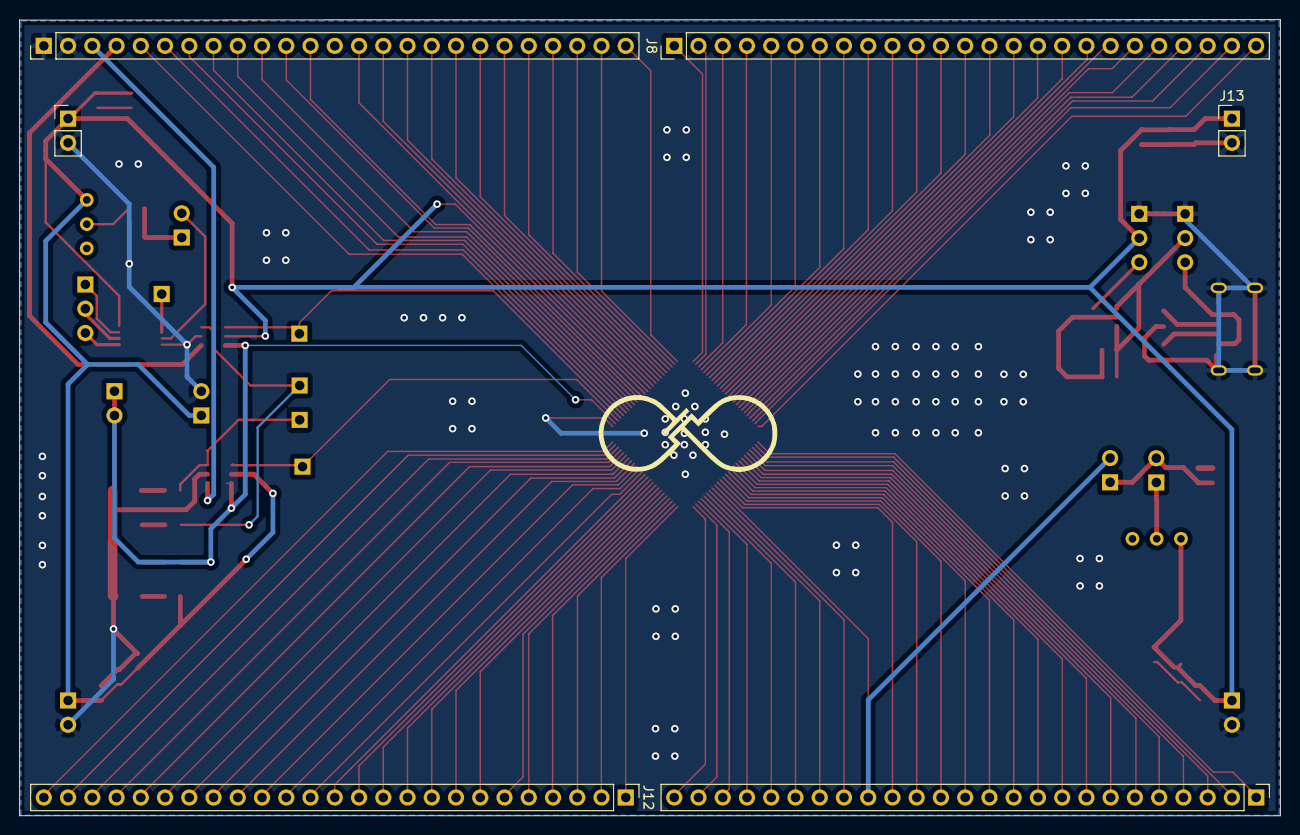
[picture p32: board combined_board.kicad_pcb from below]

Board: 2 copper layers, 132.1 x 83.4 mm, 58 parts (6 on the bottom side), 122 nets.

Other parts of the board:
MOSbius_V2: MOSbius_V2; ArtInChip_QFN-100-1EP_12x12mm_P0.4mm_EP7.4x7.4mm

Their connections:
/CC_N_D_CS: MOSbius_V2.68 (CC_N_D_CS); also elsewhere on the board
/CC_N_G_CC: MOSbius_V2.65 (CC_N_G_CC); also elsewhere on the board
/CC_N_G_CS: MOSbius_V2.66 (CC_N_G_CS); also elsewhere on the board
/CC_P_D_CC: MOSbius_V2.64 (CC_P_D_CC); also elsewhere on the board
/CC_P_D_CS: MOSbius_V2.63 (CC_P_D_CS); also elsewhere on the board
/CC_P_G_CC: MOSbius_V2.62 (CC_P_G_CC); also elsewhere on the board
/CC_P_G_CS: MOSbius_V2.61 (CC_P_G_CS); also elsewhere on the board
/CLK: MOSbius_V2.3 (CLK); also elsewhere on the board
/DATA_SBUS6: MOSbius_V2.4 (DATA_SBUS6); also elsewhere on the board
/DCC1_N_D_L_CC: MOSbius_V2.45 (DCC1_N_D_L_CC); also elsewhere on the board
/DCC1_N_D_L_CS: MOSbius_V2.46 (DCC1_N_D_L_CS); also elsewhere on the board
/DCC1_N_D_R_CC: MOSbius_V2.47 (DCC1_N_D_R_CC); also elsewhere on the board
/DCC1_N_D_R_CS: MOSbius_V2.48 (DCC1_N_D_R_CS); also elsewhere on the board
/DCC1_N_G_L_CC: MOSbius_V2.41 (DCC1_N_G_L_CC); also elsewhere on the board
/DCC1_N_G_L_CS: MOSbius_V2.42 (DCC1_N_G_L_CS); also elsewhere on the board
/DCC1_N_G_R_CC: MOSbius_V2.43 (DCC1_N_G_R_CC); also elsewhere on the board
/DCC1_N_G_R_CS: MOSbius_V2.44 (DCC1_N_G_R_CS); also elsewhere on the board
/DCC1_P_D_L_CC: MOSbius_V2.90 (DCC1_P_D_L_CC); also elsewhere on the board
/DCC1_P_D_L_CS: MOSbius_V2.89 (DCC1_P_D_L_CS); also elsewhere on the board
/DCC1_P_D_R_CC: MOSbius_V2.92 (DCC1_P_D_R_CC); also elsewhere on the board
/DCC1_P_D_R_CS: MOSbius_V2.91 (DCC1_P_D_R_CS); also elsewhere on the board
/DCC1_P_G_L_CC: MOSbius_V2.86 (DCC1_P_G_L_CC); also elsewhere on the board
/DCC1_P_G_L_CS: MOSbius_V2.85 (DCC1_P_G_L_CS); also elsewhere on the board
/DCC1_P_G_R_CC: MOSbius_V2.88 (DCC1_P_G_R_CC); also elsewhere on the board
/DCC1_P_G_R_CS: MOSbius_V2.87 (DCC1_P_G_R_CS); also elsewhere on the board
/DCC2_N_D_L_CC: MOSbius_V2.37 (DCC2_N_D_L_CC); also elsewhere on the board
/DCC2_N_D_L_CS: MOSbius_V2.38 (DCC2_N_D_L_CS); also elsewhere on the board
/DCC2_N_D_R_CC: MOSbius_V2.39 (DCC2_N_D_R_CC); also elsewhere on the board
/DCC2_N_D_R_CS: MOSbius_V2.40 (DCC2_N_D_R_CS); also elsewhere on the board
/DCC2_N_G_L_CC: MOSbius_V2.33 (DCC2_N_G_L_CC); also elsewhere on the board
/DCC2_N_G_L_CS: MOSbius_V2.34 (DCC2_N_G_L_CS); also elsewhere on the board
/DCC2_N_G_R_CC: MOSbius_V2.35 (DCC2_N_G_R_CC); also elsewhere on the board
/DCC2_N_G_R_CS: MOSbius_V2.36 (DCC2_N_G_R_CS); also elsewhere on the board
/DCC2_P_D_L_CC: MOSbius_V2.82 (DCC2_P_D_L_CC); also elsewhere on the board
/DCC2_P_D_L_CS: MOSbius_V2.81 (DCC2_P_D_L_CS); also elsewhere on the board
/DCC2_P_D_R_CC: MOSbius_V2.84 (DCC2_P_D_R_CC); also elsewhere on the board
/DCC2_P_D_R_CS: MOSbius_V2.83 (DCC2_P_D_R_CS); also elsewhere on the board
/DCC2_P_G_L_CC: MOSbius_V2.78 (DCC2_P_G_L_CC); also elsewhere on the board
/DCC2_P_G_L_CS: MOSbius_V2.77 (DCC2_P_G_L_CS); also elsewhere on the board
/DCC2_P_G_R_CC: MOSbius_V2.80 (DCC2_P_G_R_CC); also elsewhere on the board
/DCC2_P_G_R_CS: MOSbius_V2.79 (DCC2_P_G_R_CS); also elsewhere on the board
/DCC3_N_D_L_CC: MOSbius_V2.21 (DCC3_N_D_L_CC); also elsewhere on the board
/DCC3_N_D_L_CS: MOSbius_V2.22 (DCC3_N_D_L_CS); also elsewhere on the board
/DCC3_N_D_R_CC: MOSbius_V2.23 (DCC3_N_D_R_CC); also elsewhere on the board
/DCC3_N_D_R_CS: MOSbius_V2.24 (DCC3_N_D_R_CS); also elsewhere on the board
/DCC3_N_G_L_CC: MOSbius_V2.17 (DCC3_N_G_L_CC); also elsewhere on the board
/DCC3_N_G_L_CS: MOSbius_V2.18 (DCC3_N_G_L_CS); also elsewhere on the board
/DCC3_N_G_R_CC: MOSbius_V2.19 (DCC3_N_G_R_CC); also elsewhere on the board
/DCC3_N_G_R_CS: MOSbius_V2.20 (DCC3_N_G_R_CS); also elsewhere on the board
/DCC3_P_D_L_CC: MOSbius_V2.74 (DCC3_P_D_L_CC); also elsewhere on the board
/DCC3_P_D_L_CS: MOSbius_V2.73 (DCC3_P_D_L_CS); also elsewhere on the board
/DCC3_P_D_R_CC: MOSbius_V2.76 (DCC3_P_D_R_CC); also elsewhere on the board
/DCC3_P_D_R_CS: MOSbius_V2.75 (DCC3_P_D_R_CS); also elsewhere on the board
/DCC3_P_G_L_CC: MOSbius_V2.70 (DCC3_P_G_L_CC); also elsewhere on the board
/DCC3_P_G_L_CS: MOSbius_V2.69 (DCC3_P_G_L_CS); also elsewhere on the board
/DCC3_P_G_R_CC: MOSbius_V2.72 (DCC3_P_G_R_CC); also elsewhere on the board
/DCC3_P_G_R_CS: MOSbius_V2.71 (DCC3_P_G_R_CS); also elsewhere on the board
/DCC4_N_D_L_CC: MOSbius_V2.29 (DCC4_N_D_L_CC); also elsewhere on the board
/DCC4_N_D_L_CS: MOSbius_V2.30 (DCC4_N_D_L_CS); also elsewhere on the board
/DCC4_N_D_R_CC: MOSbius_V2.31 (DCC4_N_D_R_CC); also elsewhere on the board
/DCC4_N_D_R_CS: MOSbius_V2.32 (DCC4_N_D_R_CS); also elsewhere on the board
/DCC4_N_G_L_CC: MOSbius_V2.25 (DCC4_N_G_L_CC); also elsewhere on the board
/DCC4_N_G_L_CS: MOSbius_V2.26 (DCC4_N_G_L_CS); also elsewhere on the board
/DCC4_N_G_R_CC: MOSbius_V2.27 (DCC4_N_G_R_CC); also elsewhere on the board
/DCC4_N_G_R_CS: MOSbius_V2.28 (DCC4_N_G_R_CS); also elsewhere on the board
/DCC4_P_D_L_CC: MOSbius_V2.98 (DCC4_P_D_L_CC); also elsewhere on the board
/DCC4_P_D_L_CS: MOSbius_V2.97 (DCC4_P_D_L_CS); also elsewhere on the board
/DCC4_P_D_R_CC: MOSbius_V2.100 (DCC4_P_D_R_CC); also elsewhere on the board
/DCC4_P_D_R_CS: MOSbius_V2.99 (DCC4_P_D_R_CS); also elsewhere on the board
/DCC4_P_G_L_CC: MOSbius_V2.94 (DCC4_P_G_L_CC); also elsewhere on the board
/DCC4_P_G_L_CS: MOSbius_V2.93 (DCC4_P_G_L_CS); also elsewhere on the board
/DCC4_P_G_R_CC: MOSbius_V2.96 (DCC4_P_G_R_CC); also elsewhere on the board
/DCC4_P_G_R_CS: MOSbius_V2.95 (DCC4_P_G_R_CS); also elsewhere on the board
/DINV1_INN_L: MOSbius_V2.56 (DINV1_INN_L); also elsewhere on the board
/DINV1_INN_R: MOSbius_V2.59 (DINV1_INN_R); also elsewhere on the board
/DINV1_INP_L: MOSbius_V2.55 (DINV1_INP_L); also elsewhere on the board
/DINV1_INP_R: MOSbius_V2.58 (DINV1_INP_R); also elsewhere on the board
/DINV1_OUT_L: MOSbius_V2.57 (DINV1_OUT_L); also elsewhere on the board
/DINV1_OUT_R: MOSbius_V2.60 (DINV1_OUT_R); also elsewhere on the board
/DINV2_INN_L: MOSbius_V2.50 (DINV2_INN_L); also elsewhere on the board
/DINV2_INN_R: MOSbius_V2.53 (DINV2_INN_R); also elsewhere on the board
/DINV2_INP_L: MOSbius_V2.49 (DINV2_INP_L); also elsewhere on the board
/DINV2_INP_R: MOSbius_V2.52 (DINV2_INP_R); also elsewhere on the board
/DINV2_OUT_L: MOSbius_V2.51 (DINV2_OUT_L); also elsewhere on the board
/DINV2_OUT_R: MOSbius_V2.54 (DINV2_OUT_R); also elsewhere on the board
/EN: MOSbius_V2.2 (EN); also elsewhere on the board
/OTA_N_INN: MOSbius_V2.15 (OTA_N_INN); also elsewhere on the board
/OTA_N_INP: MOSbius_V2.14 (OTA_N_INP); also elsewhere on the board
/OTA_N_OUT: MOSbius_V2.16 (OTA_N_OUT); also elsewhere on the board
/OTA_P_INN: MOSbius_V2.10 (OTA_P_INN); also elsewhere on the board
/OTA_P_INP: MOSbius_V2.11 (OTA_P_INP); also elsewhere on the board
/OTA_P_OUT: MOSbius_V2.12 (OTA_P_OUT); also elsewhere on the board
/SBUS1: MOSbius_V2.9 (SBUS1); also elsewhere on the board
/SBUS2: MOSbius_V2.8 (SBUS2); also elsewhere on the board
/SBUS3: MOSbius_V2.7 (SBUS3); also elsewhere on the board
/SBUS4: MOSbius_V2.6 (SBUS4); also elsewhere on the board
/SBUS5: MOSbius_V2.5 (SBUS5); also elsewhere on the board
GND: MOSbius_V2.1 (VSS); also elsewhere on the board
ISINK_REF: MOSbius_V2.67 (CC_N_D_CC); also elsewhere on the board
VDD: MOSbius_V2.13 (VDD); also elsewhere on the board
