xL1n/MOSBius_V2_PCB/MOSbius_DevKit_v5/MOSbius_DevKit_v5.kicad_pcb

## KiCad design MOSbius_DevKit_v5/MOSbius_DevKit_v5.kicad_pcb (2026-03-12)

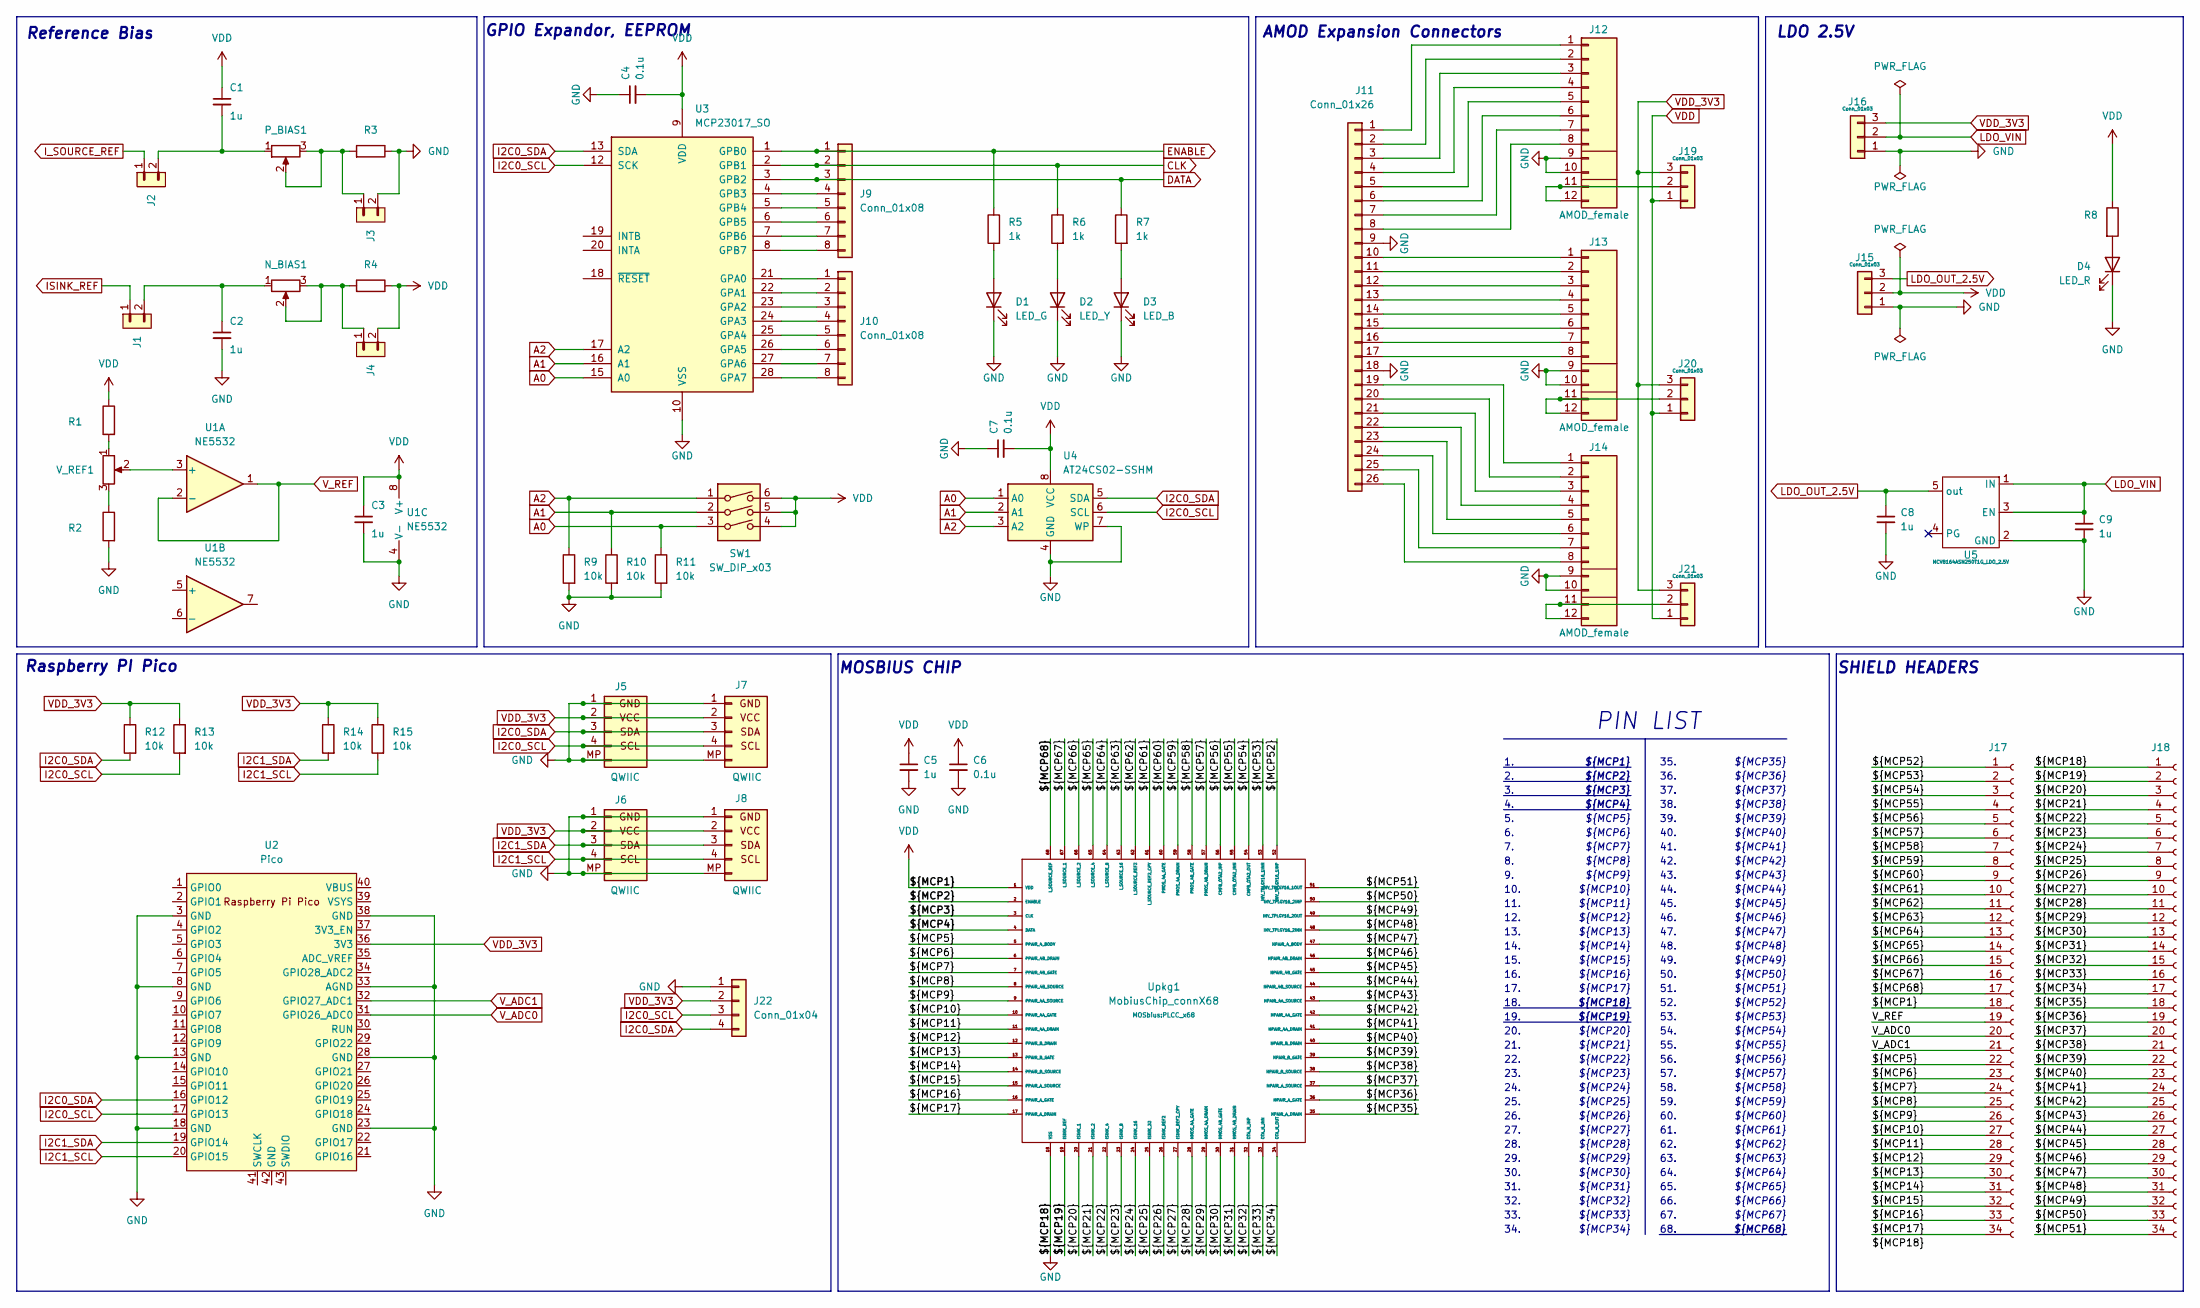
[picture p33: schematic MOSbius_DevKit_v5.kicad_sch, MobiusPCB_v3_2024]

Parts:
C1, C2, C3, C5, C8, C9: 1u; C_0603_1608Metric
C4, C6, C7: 0.1u; C_0603_1608Metric
D1: LED_G; LED_0805_2012Metric
D2: LED_Y; LED_0805_2012Metric
D3: LED_B; LED_0805_2012Metric
D4: LED_R; LED_0805_2012Metric
J1, J2, J3, J4: PINHD_1x2_Male; PinHeader_1x02_P2.54mm_Vertical
J5, J6, J7, J8: QWIIC; JST_SH_SM04B-SRSS-TB_1x04-1MP_P1.00mm_Horizontal
J9, J10: Conn_01x08; PinHeader_1x08_P2.54mm_Vertical
J11: Conn_01x26; PinHeader_1x26_P2.54mm_Vertical
J12, J13, J14: AMOD_female
J15, J16, J19, J20, J21: Conn_01x03; PinHeader_1x03_P2.54mm_Vertical
J17, J18: Conn_01x34_Socket; PinHeader_1x34_P2.54mm_Vertical
J22: Conn_01x04; PinHeader_1x04_P2.54mm_Vertical
N_BIAS1: R_Potentiometer; Potentiometer_Bourns_3296W_Vertical
P_BIAS1: R_Potentiometer; Potentiometer_Bourns_3296W_Vertical
R1, R2, R3, R4: 1.3K; R_0603_1608Metric
R5, R6, R7, R8: 1k; R_0603_1608Metric
R9, R10, R11, R12, R13, R14, R15: 10k; R_0603_1608Metric
SW1: SW_DIP_x03; SW_DIP_SPSTx03_Slide_Omron_A6S-310x_W8.9mm_P2.54mm
U1: NE5532
U2: Pico; RPi_Pico_SMD_TH
U3: MCP23017_SO; SOIC-28W_7.5x17.9mm_P1.27mm
U4: AT24CS02-SSHM; SOIC-8_3.9x4.9mm_P1.27mm
U5: NCV8164ASN250T1G_LDO_2.5V; SOT-23-5
Upkg1: MobiusChip_connX68; PLCC_x68
V_REF1: R_Potentiometer; Potentiometer_Bourns_3296W_Vertical

Connections:
/CMFB_OTA2_INN: J17.4, Upkg1.55 (CMFB_OTA2_INN)
/CMFB_OTA2_INP: J17.5, Upkg1.56 (CMFB_OTA2_INP)
/CMFB_OTA2_OUT: J17.3, Upkg1.54 (CMFB_OTA2_OUT)
/INV_TPLGY16_1INN: J17.2, Upkg1.53 (INV_TPLGY16_1INN)
/INV_TPLGY16_1INP: J17.1, Upkg1.52 (INV_TPLGY16_1INP)
/INV_TPLGY16_1OUT: J18.34, Upkg1.51 (INV_TPLGY16_1OUT)
/INV_TPLGY16_2INN: J18.31, Upkg1.48 (INV_TPLGY16_2INN)
/INV_TPLGY16_2INP: J18.33, Upkg1.50 (INV_TPLGY16_2INP)
/INV_TPLGY16_2OUT: J18.32, Upkg1.49 (INV_TPLGY16_2OUT)
/ISINK_1: J18.3, Upkg1.20 (ISINK_1)
/ISINK_2: J18.4, Upkg1.21 (ISINK_2)
/ISINK_4: J18.5, Upkg1.22 (ISINK_4)
/ISINK_8: J18.6, Upkg1.23 (ISINK_8)
/ISINK_16: J18.7, Upkg1.24 (ISINK_16)
/ISINK_32: J18.8, Upkg1.25 (ISINK_32)
/ISINK_REF2: J18.9, Upkg1.26 (ISINK_REF2)
/ISINK_REF2_CPY: J18.10, Upkg1.27 (ISINK_REF2_CPY)
/I_SOURCE_1: J17.16, Upkg1.67 (I_SOURCE_1)
/I_SOURCE_2: J17.15, Upkg1.66 (I_SOURCE_2)
/I_SOURCE_4: J17.14, Upkg1.65 (I_SOURCE_4)
/I_SOURCE_8: J17.13, Upkg1.64 (I_SOURCE_8)
/I_SOURCE_16: J17.12, Upkg1.63 (I_SOURCE_16)
/I_SOURCE_REF2: J17.11, Upkg1.62 (I_SOURCE_REF2)
/I_SOURCE_REF2_CPY: J17.10, Upkg1.61 (I_SOURCE_REF2_CPY)
/NMOS_4A_DRAIN: J18.12, Upkg1.29 (NMOS_4A_DRAIN)
/NMOS_4A_GATE: J18.11, Upkg1.28 (NMOS_4A_GATE)
/NMOS_4B_DRAIN: J18.14, Upkg1.31 (NMOS_4B_DRAIN)
/NMOS_4B_GATE: J18.13, Upkg1.30 (NMOS_4B_GATE)
/NPAIR_4A_DRAIN: J18.24, Upkg1.41 (NPAIR_4A_DRAIN)
/NPAIR_4A_GATE: J18.25, Upkg1.42 (NPAIR_4A_GATE)
/NPAIR_4A_SOURCE: J18.26, Upkg1.43 (NPAIR_4A_SOURCE)
/NPAIR_4B_DRAIN: J18.29, Upkg1.46 (NPAIR_4B_DRAIN)
/NPAIR_4B_GATE: J18.28, Upkg1.45 (NPAIR_4B_GATE)
/NPAIR_4B_SOURCE: J18.27, Upkg1.44 (NPAIR_4B_SOURCE)
/NPAIR_4_BODY: J18.30, Upkg1.47 (NPAIR_4_BODY)
/NPAIR_A_DRAIN: J18.18, Upkg1.35 (NPAIR_A_DRAIN)
/NPAIR_A_GATE: J18.19, Upkg1.36 (NPAIR_A_GATE)
/NPAIR_A_SOURCE: J18.20, Upkg1.37 (NPAIR_A_SOURCE)
/NPAIR_B_DRAIN: J18.23, Upkg1.40 (NPAIR_B_DRAIN)
/NPAIR_B_GATE: J18.22, Upkg1.39 (NPAIR_B_GATE)
/NPAIR_B_SOURCE: J18.21, Upkg1.38 (NPAIR_B_SOURCE)
/OTA_N_INN: J18.16, Upkg1.33 (OTA_N_INN)
/OTA_N_INP: J18.15, Upkg1.32 (OTA_N_INP)
/OTA_N_OUT: J18.17, Upkg1.34 (OTA_N_OUT)
/PMOS_4A_DRAIN: J17.8, Upkg1.59 (PMOS_4A_DRAIN)
/PMOS_4A_GATE: J17.9, Upkg1.60 (PMOS_4A_GATE)
/PMOS_4B_DRAIN: J17.6, Upkg1.57 (PMOS_4B_DRAIN)
/PMOS_4B_GATE: J17.7, Upkg1.58 (PMOS_4B_GATE)
/PPAIR_4A_DRAIN: J17.28, Upkg1.11 (PPAIR_4A_DRAIN)
/PPAIR_4A_GATE: J17.27, Upkg1.10 (PPAIR_4A_GATE)
/PPAIR_4A_SOURCE: J17.26, Upkg1.9 (PPAIR_4A_SOURCE)
/PPAIR_4B_DRAIN: J17.23, Upkg1.6 (PPAIR_4B_DRAIN)
/PPAIR_4B_GATE: J17.24, Upkg1.7 (PPAIR_4B_GATE)
/PPAIR_4B_SOURCE: J17.25, Upkg1.8 (PPAIR_4B_SOURCE)
/PPAIR_4_BODY: J17.22, Upkg1.5 (PPAIR_4_BODY)
/PPAIR_A_DRAIN: J17.34, Upkg1.17 (PPAIR_A_DRAIN)
/PPAIR_A_GATE: J17.33, Upkg1.16 (PPAIR_A_GATE)
/PPAIR_A_SOURCE: J17.32, Upkg1.15 (PPAIR_A_SOURCE)
/PPAIR_B_DRAIN: J17.29, Upkg1.12 (PPAIR_B_DRAIN)
/PPAIR_B_GATE: J17.30, Upkg1.13 (PPAIR_B_GATE)
/PPAIR_B_SOURCE: J17.31, Upkg1.14 (PPAIR_B_SOURCE)
A0: R11.1, SW1.3, U3.15 (A0), U4.1 (A0)
A1: R10.1, SW1.2, U3.16 (A1), U4.2 (A1)
A2: R9.1, SW1.1, U3.17 (A2), U4.3 (A2)
GND: C2.2, C3.2, C4.1, C5.2, C6.2, C7.1, C8.2, C9.2, D1.1 (K), D2.1 (K), D3.1 (K), D4.1 (K), J3.2, J5.1, J5.MP, J6.1, J6.MP, J7.1, J7.MP, J8.1, J8.MP, J11.9, J11.18, J12.9, J12.10, J13.9, J13.10, J14.9, J14.10, J15.1, J16.1, J18.1, J22.1, R2.2, R3.1, R9.2, R10.2, R11.2, U1.4 (V-), U2.3 (GND), U2.8 (GND), U2.13 (GND), U2.18 (GND), U2.23 (GND), U2.28 (GND), U2.33 (AGND), U2.38 (GND), U3.10 (VSS), U4.4 (GND), U4.7 (WP), U5.2 (GND), Upkg1.18 (VSS)
I2C0_SCL: J5.4, J7.4, J22.3, R13.2, U2.17 (GPIO13), U3.12 (SCK), U4.6 (SCL)
I2C0_SDA: J5.3, J7.3, J22.4, R12.2, U2.16 (GPIO12), U3.13 (SDA), U4.5 (SDA)
I2C1_SCL: J6.4, J8.4, R15.2, U2.20 (GPIO15)
I2C1_SDA: J6.3, J8.3, R14.2, U2.19 (GPIO14)
LDO_OUT_2.5V: C8.1, J15.3, U5.5 (out)
LDO_VIN: C9.1, J16.2, U5.1 (IN), U5.3 (EN)
unnamed: C1.2, J2.2, P_BIAS1.1
unnamed: C2.1, J1.2, N_BIAS1.1
unnamed: D1.2 (A), R5.2
unnamed: D2.2 (A), R6.2
unnamed: D3.2 (A), R7.2
unnamed: D4.2 (A), R8.2
unnamed: J3.1, P_BIAS1.2, P_BIAS1.3, R3.2
unnamed: J4.1, N_BIAS1.2, N_BIAS1.3, R4.2
unnamed: J9.4, U3.4 (GPB3)
unnamed: J9.5, U3.5 (GPB4)
unnamed: J9.6, U3.6 (GPB5)
unnamed: J9.7, U3.7 (GPB6)
unnamed: J9.8, U3.8 (GPB7)
unnamed: J10.1, U3.21 (GPA0)
unnamed: J10.2, U3.22 (GPA1)
unnamed: J10.3, U3.23 (GPA2)
unnamed: J10.4, U3.24 (GPA3)
unnamed: J10.5, U3.25 (GPA4)
unnamed: J10.6, U3.26 (GPA5)
unnamed: J10.7, U3.27 (GPA6)
unnamed: J10.8, U3.28 (GPA7)
unnamed: J11.1, J12.1
unnamed: J11.2, J12.2
unnamed: J11.3, J12.3
unnamed: J11.4, J12.4
unnamed: J11.5, J12.5
unnamed: J11.6, J12.6
unnamed: J11.7, J12.7
unnamed: J11.8, J12.8
unnamed: J11.10, J13.1
unnamed: J11.11, J13.2
unnamed: J11.12, J13.3
unnamed: J11.13, J13.4
unnamed: J11.14, J13.5
unnamed: J11.15, J13.6
unnamed: J11.16, J13.7
unnamed: J11.17, J13.8
unnamed: J11.19, J14.1
unnamed: J11.20, J14.2
unnamed: J11.21, J14.3
unnamed: J11.22, J14.4
unnamed: J11.23, J14.5
unnamed: J11.24, J14.6
unnamed: J11.25, J14.7
unnamed: J11.26, J14.8
unnamed: J12.11, J12.12, J19.2
unnamed: J13.11, J13.12, J20.2
unnamed: J14.11, J14.12, J21.2
unnamed: R1.2, V_REF1.1
unnamed: R2.1, V_REF1.3
unnamed: U1.3 (+), V_REF1.2
VDD: C1.1, C3.1, C4.2, C5.1, C6.1, C7.2, J4.2, J15.2, J17.18, J19.1, J20.1, J21.1, R1.1, R4.1, R8.1, SW1.4, SW1.5, SW1.6, U1.8 (V+), U3.9 (VDD), U4.8 (VCC), Upkg1.1 (VDD)
VDD_3V3: J5.2, J6.2, J7.2, J8.2, J16.3, J19.3, J20.3, J21.3, J22.2, R12.1, R13.1, R14.1, R15.1, U2.36 (3V3)
V_ADC0: J17.20, U2.31 (GPIO26_ADC0)
V_ADC1: J17.21, U2.32 (GPIO27_ADC1)
V_REF: J17.19, U1.1, U1.2 (-)

Notes on the sheet:
${MCP9}
18.
${MCP61}
${MCP12}
65.
SHIELD HEADERS
58.
39.
12.
55.
${MCP66}
${MCP39}
${MCP55}
${MCP35}
59.
${MCP57}
${MCP43}
44.
${MCP27}
14.
${MCP46}
19.
60.
${MCP44}
${MCP37}
66.
41.
42.
31.
${MCP4}
22.
Raspberry PI Pico
${MCP18}
Reference Bias
40.
${MCP7}
${MCP34}
${MCP51}
16.
PIN LIST
30.
${MCP67}
67.
57.
LDO 2.5V
29.
38.
20.
${MCP13}
${MCP29}
${MCP53}
46.
${MCP10}
${MCP31}
${MCP3}
15.
${MCP42}
${MCP59}
56.
36.
23.
${MCP14}
${MCP64}
11.
${MCP30}
${MCP20}
${MCP17}
28.
21.
62.
24.
${MCP5}
37.
48.
${MCP49}
${MCP36}
${MCP58}
${MCP22}
${MCP68}
${MCP19}
${MCP45}
${MCP50}
32.
10.
43.
${MCP62}
${MCP1}
${MCP38}
13.
63.
${MCP11}
${MCP23}
${MCP24}
68.
45.
26.
${MCP48}
${MCP41}
35.
${MCP16}
${MCP56}
33.
${MCP26}
${MCP21}
54.
64.
17.
${MCP52}
${MCP60}
GPIO Expandor, EEPROM
AMOD Expansion Connectors
47.
${MCP63}
${MCP6}
27.
${MCP40}
61.
${MCP32}
52.
${MCP54}
${MCP15}
${MCP2}
50.
25.
49.
${MCP25}
${MCP8}
34.
53.
${MCP28}
${MCP33}
51.
${MCP65}
${MCP47}
MOSBIUS CHIP

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
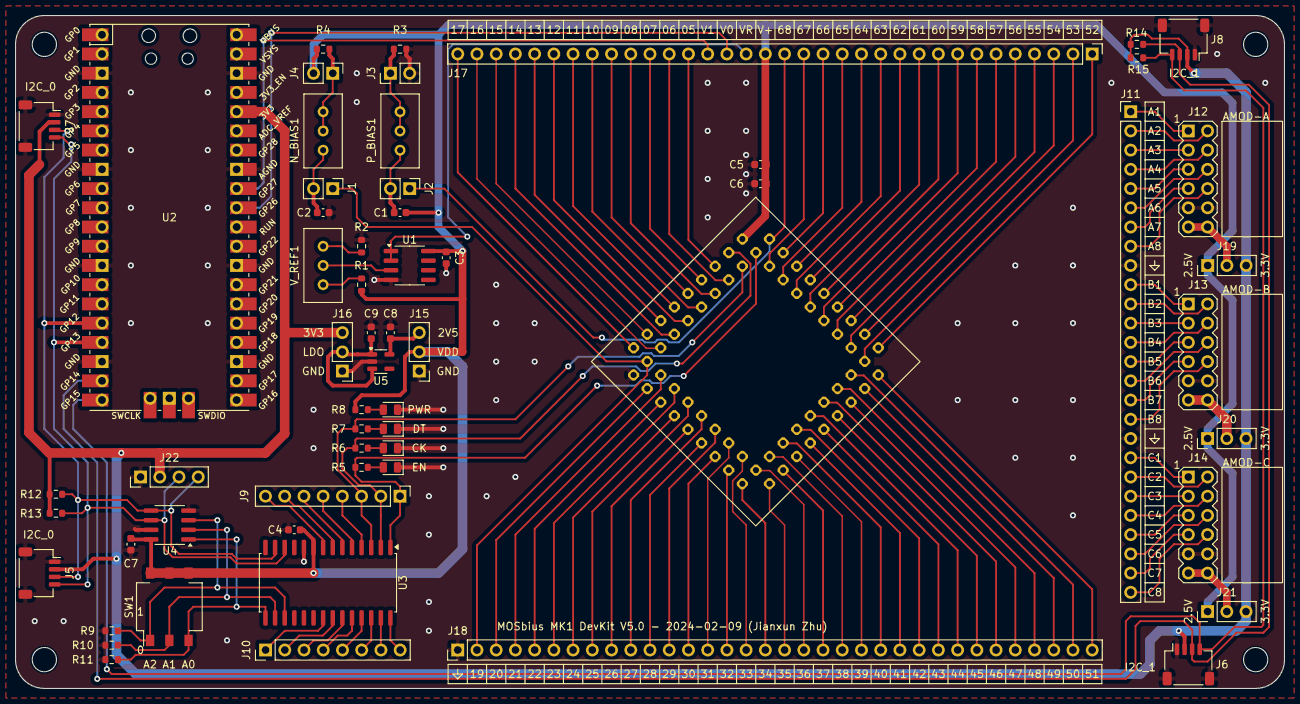
[picture p34: board MOSbius_DevKit_v5.kicad_pcb from above]

Board: 2 copper layers, 167.6 x 88.9 mm, 64 parts (0 on the bottom side), 132 nets.

Other parts of the board:
H1, H2, H3, H4: MountingHole; MountingHole_3.2mm_M3_ISO7380
