xL1n/MOSBius_V2_PCB/MOSbiusPCB_v3b_2025 (pcbway fab correct schematic)/MOSbiusPCB_v3b_2024.kicad_pcb

## KiCad design MOSbiusPCB_v3b_2025 (pcbway fab correct schematic)/MOSbiusPCB_v3b_2024.kicad_pcb (2025-09-01)

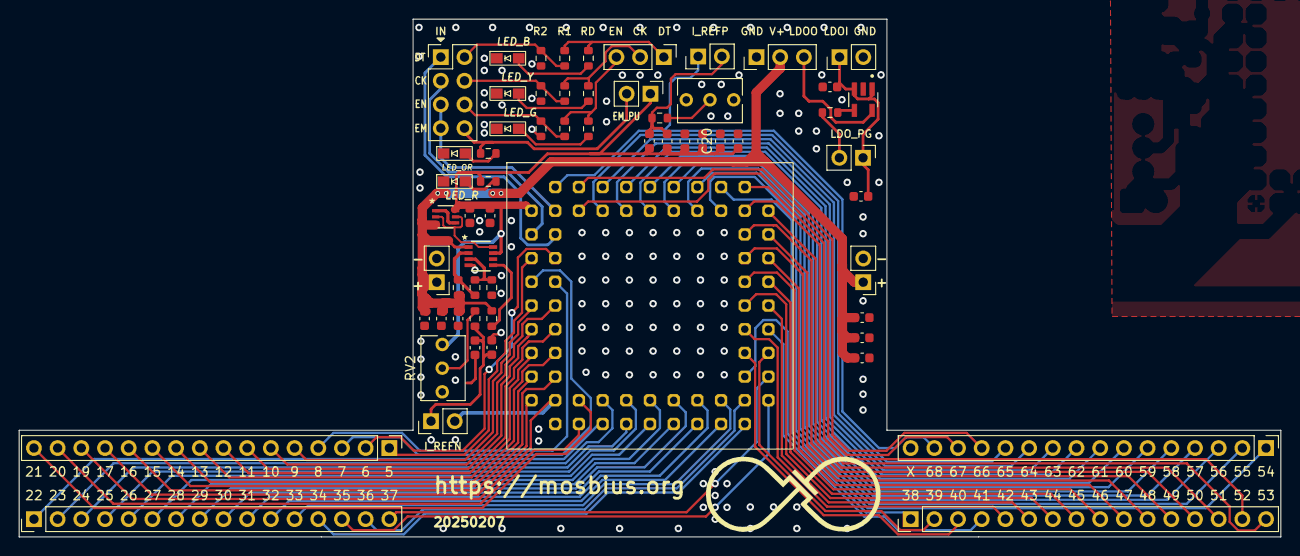
[picture p37: board MOSbiusPCB_v3b_2024.kicad_pcb from above]

Board: 2 copper layers, 135.3 x 55.5 mm, 61 parts (0 on the bottom side), 94 nets.

Parts:
C1, C4, C6, C8, C9, C15, C18: 1u; C_0603_1608Metric
C2, C3, C7, C10, C16, C17: 0.1u; C_0603_1608Metric
C5, C12, C14, C19: 10u; C_0603_1608Metric
C20: 47u; C_0603_1608Metric
D1: LED_OR; SunLED_LED_XZC_0805
D2: LED_G; SunLED_LED_XZC_0805
D3: LED_Y; SunLED_LED_XZC_0805
D4: LED_B; SunLED_LED_XZC_0805
D5: LED_R; SunLED_LED_XZC_0805
J1, J2, J3, J4: Conn_01x16_Pin; PinHeader_1x16_P2.54mm_Vertical
J5, J7, J8: PINHD_1x2_Male; PinHeader_1x02_P2.54mm_Vertical
J6: Conn_01x02_Pin; PinHeader_1x02_P2.54mm_Vertical
J10: Conn_02x04_Row_Letter_First; PinHeader_2x04_P2.54mm_Vertical
J14_GND2, J14_GND3: Conn_01x03; PinHeader_1x03_P2.54mm_Vertical
J18_VDC1: Conn_01x02; PinHeader_1x02_P2.54mm_Vertical
JP1_LDOPG1, JP2_EN1: Jumper_2_Open; PinHeader_1x02_P2.54mm_Vertical
R1, R3, R5, R11, R18: 1.1k; R_0603_1608Metric
R2, R4, R6: 3.3k; R_0603_1608Metric
R7, R9, R17, R19: 330; R_0603_1608Metric
R8: 750; R_0603_1608Metric
R10: 10K; R_0603_1608Metric
R13, R16: 0; R_0603_1608Metric
R14: 510K; R_0603_1608Metric
R15: 120K; R_0603_1608Metric
RV1, RV2: 25k_POT; Potentiometer_Bourns_3266Y_Vertical
U1: NCV8164ASN250T1G_LDO_2.5V; NCV8164ASN250T1G
U2: LTC4365TS8; TSOT-23_TS8_LIT
U3: UM6K34NTCN; TRANS_UM6J1_ROM
Upkg1: MobiusChip_connX68; PLCC_x68

Connections:
/CMFB_OTA2_INN: J4.2, Upkg1.55 (CMFB_OTA2_INN)
/CMFB_OTA2_INP: J4.3, Upkg1.56 (CMFB_OTA2_INP)
/CMFB_OTA2_OUT: J4.1, Upkg1.54 (CMFB_OTA2_OUT)
/INV_TPLGY16_1INN: J3.16, Upkg1.53 (INV_TPLGY16_1INN)
/INV_TPLGY16_1INP: J3.15, Upkg1.52 (INV_TPLGY16_1INP)
/INV_TPLGY16_1OUT: J3.14, Upkg1.51 (INV_TPLGY16_1OUT)
/INV_TPLGY16_2INN: J3.11, Upkg1.48 (INV_TPLGY16_2INN)
/INV_TPLGY16_2INP: J3.13, Upkg1.50 (INV_TPLGY16_2INP)
/INV_TPLGY16_2OUT: J3.12, Upkg1.49 (INV_TPLGY16_2OUT)
/ISINK_1: J1.15, Upkg1.20 (ISINK_1)
/ISINK_2: J1.16, Upkg1.21 (ISINK_2)
/ISINK_4: J2.1, Upkg1.22 (ISINK_4)
/ISINK_8: J2.2, Upkg1.23 (ISINK_8)
/ISINK_16: J2.3, Upkg1.24 (ISINK_16)
/ISINK_32: J2.4, Upkg1.25 (ISINK_32)
/ISINK_REF2: J2.5, Upkg1.26 (ISINK_REF2)
/ISINK_REF2_CPY: J2.6, Upkg1.27 (ISINK_REF2_CPY)
/I_SOURCE_1: J4.14, Upkg1.67 (I_SOURCE_1)
/I_SOURCE_2: J4.13, Upkg1.66 (I_SOURCE_2)
/I_SOURCE_4: J4.12, Upkg1.65 (I_SOURCE_4)
/I_SOURCE_8: J4.11, Upkg1.64 (I_SOURCE_8)
/I_SOURCE_16: J4.10, Upkg1.63 (I_SOURCE_16)
/I_SOURCE_REF2: J4.9, Upkg1.62 (I_SOURCE_REF2)
/I_SOURCE_REF2_CPY: J4.8, Upkg1.61 (I_SOURCE_REF2_CPY)
/NMOS_4A_DRAIN: J2.8, Upkg1.29 (NMOS_4A_DRAIN)
/NMOS_4A_GATE: J2.7, Upkg1.28 (NMOS_4A_GATE)
/NMOS_4B_DRAIN: J2.10, Upkg1.31 (NMOS_4B_DRAIN)
/NMOS_4B_GATE: J2.9, Upkg1.30 (NMOS_4B_GATE)
/NPAIR_4A_DRAIN: J3.4, Upkg1.41 (NPAIR_4A_DRAIN)
/NPAIR_4A_GATE: J3.5, Upkg1.42 (NPAIR_4A_GATE)
/NPAIR_4A_SOURCE: J3.6, Upkg1.43 (NPAIR_4A_SOURCE)
/NPAIR_4B_DRAIN: J3.9, Upkg1.46 (NPAIR_4B_DRAIN)
/NPAIR_4B_GATE: J3.8, Upkg1.45 (NPAIR_4B_GATE)
/NPAIR_4B_SOURCE: J3.7, Upkg1.44 (NPAIR_4B_SOURCE)
/NPAIR_4_BODY: J3.10, Upkg1.47 (NPAIR_4_BODY)
/NPAIR_A_DRAIN: J2.14, Upkg1.35 (NPAIR_A_DRAIN)
/NPAIR_A_GATE: J2.15, Upkg1.36 (NPAIR_A_GATE)
/NPAIR_A_SOURCE: J2.16, Upkg1.37 (NPAIR_A_SOURCE)
/NPAIR_B_DRAIN: J3.3, Upkg1.40 (NPAIR_B_DRAIN)
/NPAIR_B_GATE: J3.2, Upkg1.39 (NPAIR_B_GATE)
/NPAIR_B_SOURCE: J3.1, Upkg1.38 (NPAIR_B_SOURCE)
/OTA_N_INN: J2.12, Upkg1.33 (OTA_N_INN)
/OTA_N_INP: J2.11, Upkg1.32 (OTA_N_INP)
/OTA_N_OUT: J2.13, Upkg1.34 (OTA_N_OUT)
/PMOS_4A_DRAIN: J4.6, Upkg1.59 (PMOS_4A_DRAIN)
/PMOS_4A_GATE: J4.7, Upkg1.60 (PMOS_4A_GATE)
/PMOS_4B_DRAIN: J4.4, Upkg1.57 (PMOS_4B_DRAIN)
/PMOS_4B_GATE: J4.5, Upkg1.58 (PMOS_4B_GATE)
/PPAIR_4A_DRAIN: J1.7, Upkg1.11 (PPAIR_4A_DRAIN)
/PPAIR_4A_GATE: J1.6, Upkg1.10 (PPAIR_4A_GATE)
/PPAIR_4A_SOURCE: J1.5, Upkg1.9 (PPAIR_4A_SOURCE)
/PPAIR_4B_DRAIN: J1.2, Upkg1.6 (PPAIR_4B_DRAIN)
/PPAIR_4B_GATE: J1.3, Upkg1.7 (PPAIR_4B_GATE)
/PPAIR_4B_SOURCE: J1.4, Upkg1.8 (PPAIR_4B_SOURCE)
/PPAIR_4_BODY: J1.1, Upkg1.5 (PPAIR_4_BODY)
/PPAIR_A_DRAIN: J1.13, Upkg1.17 (PPAIR_A_DRAIN)
/PPAIR_A_GATE: J1.12, Upkg1.16 (PPAIR_A_GATE)
/PPAIR_A_SOURCE: J1.11, Upkg1.15 (PPAIR_A_SOURCE)
/PPAIR_B_DRAIN: J1.8, Upkg1.12 (PPAIR_B_DRAIN)
/PPAIR_B_GATE: J1.9, Upkg1.13 (PPAIR_B_GATE)
/PPAIR_B_SOURCE: J1.10, Upkg1.14 (PPAIR_B_SOURCE)
CLK: J10.3, Upkg1.3 (CLK)
CLK_CVRT_2.5V: J10.4, R3.2, R4.1
CLK_CVRT_3.3V: J14_GND2.2, R3.1, R8.1
DATA: J10.1, Upkg1.4 (DATA)
DATA_CVRT_2.5V: J10.2, R5.2, R6.1
DATA_CVRT_3.3V: J14_GND2.1, R5.1, R9.1
ENABLE: J10.5, J10.7, Upkg1.2 (ENABLE)
EN_CVRT_2.5V: J10.6, R1.2, R2.1
EN_CVRT_3.3V: J14_GND2.3, R1.1, R7.1
EN_MAN_2.5V: J10.8, JP2_EN1.2 (B), R19.1
GND: C1.2, C2.2, C4.2, C5.2, C6.2, C7.2, C9.2, C10.2, C12.2, C14.2, C15.2, C16.2, C17.2, C18.2, C19.2, C20.2, D1.1 (K), D2.1 (K), D3.1 (K), D4.1 (K), D5.1 (K), J5.2, J6.2, J14_GND3.1, J18_VDC1.2, R2.2, R4.2, R6.2, R15.2, RV1.3, U1.2 (GND), U2.4 (GND), Upkg1.18 (VSS)
ISINK_REF: J1.14, J7.2, Upkg1.19 (ISINK_REF)
I_SOURCE_REF: J4.15, J8.1, Upkg1.68 (I_SOURCE_REF)
LDO_OUT_2.5V: J14_GND3.3, U1.5 (out)
LDO_PG_2.5V: R10.1, U1.4 (PG)
LDO_VIN: C4.1, C5.1, J18_VDC1.1, JP1_LDOPG1.1 (A), U1.1 (IN), U1.3 (EN)
unnamed: C1.1, C2.1, J7.1, R18.2
unnamed: C3.2, C8.2, J8.2, R11.2
unnamed: D1.2 (A), R19.2
unnamed: D2.2 (A), R7.2
unnamed: D3.2 (A), R8.2
unnamed: D4.2 (A), R9.2
unnamed: D5.2 (A), R17.2
unnamed: JP1_LDOPG1.2 (B), R10.2
unnamed: R11.1, RV1.2
unnamed: R18.1, RV2.2
unnamed: U2.8 (GATE), U3.2, U3.5
unnamed: R14.2, R15.1, U2.3 (OV)
unnamed: R13.2, R14.1, U2.2 (UV)
unnamed: R16.2, U2.5 (~SHDN)
unnamed: U3.1, U3.4
VD: C9.1, C10.1, C12.1, C14.1, C15.1, C16.1, J5.1, J6.1, J14_GND3.2, R13.1, R16.1, U2.1 (Vin), U3.3
VDD: C3.1, C6.1, C7.1, C8.1, C17.1, C18.1, C19.1, C20.1, JP2_EN1.1 (A), R17.1, RV2.1, U2.7 (Vout), U3.6, Upkg1.1 (VDD)
