xL1n/MOSBius_V2_PCB/Daughter_Card/Daughter_Card.kicad_pcb

## KiCad design Daughter_Card/Daughter_Card.kicad_pcb (2025-09-19)

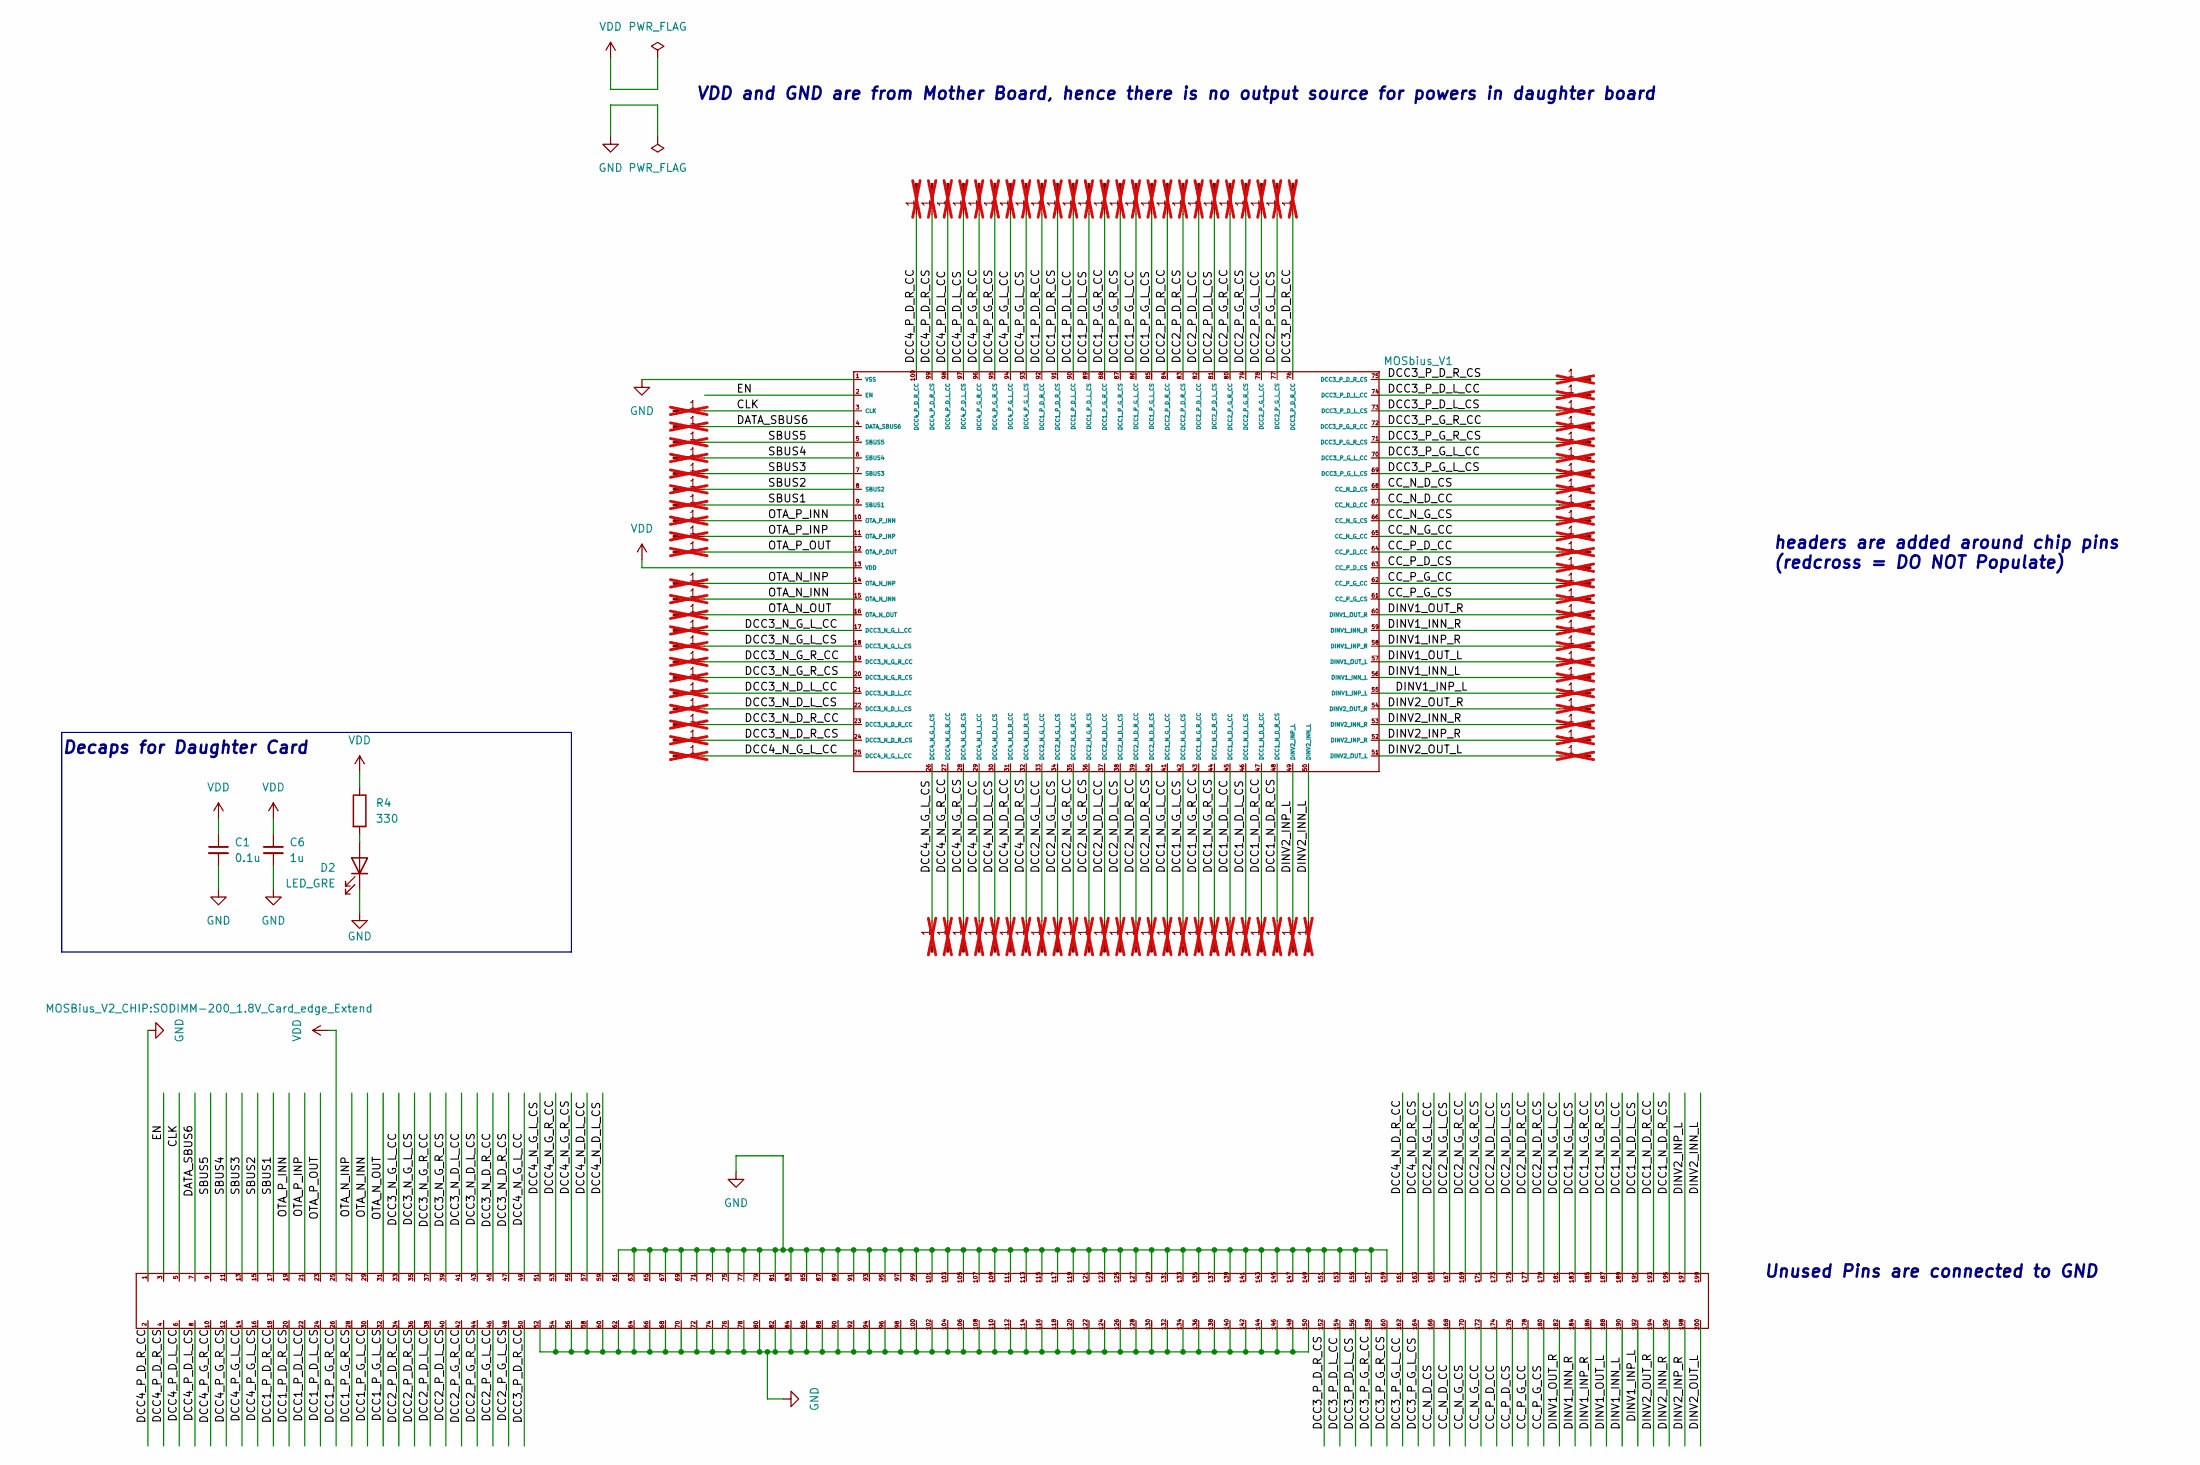
[picture p38: schematic Daughter_Card.kicad_sch, MOSbius V2 Darughter Card PCB]

Parts:
C1: 0.1u; C_0603_1608Metric
C6: 1u; C_0603_1608Metric
D2: LED_GRE; LED_150120RS75000_WRE
Daughter_Card_PIN1: SODIMM-200_1.8V_Card_edge_Extend
MOSbius_V1: MOSbius_V2; ArtInChip_QFN-100-1EP_12x12mm_P0.4mm_EP7.4x7.4mm
P3, P4, P5, P6, P7, P8, P9, P10, P11, P12, P14, P15, P16, P17, P18, P19, P20, P21, P22, P23, P24, P25, P26, P27, P28, P29, P30, P31, P32, P33, P34, P35, P36, P37, P38, P39, P40, P41, P42, P43, P44, P45, P46, P47, P48, P49, P50, P51, P52, P53, P54, P55, P56, P57, P58, P59, P60, P61, P62, P63, P64, P65, P66, P67, P68, P69, P70, P71, P72, P73, P74, P75, P76, P77, P78, P79, P80, P81, P82, P83, P84, P85, P86, P87, P88, P89, P90, P91, P92, P93, P94, P95, P96, P97, P98, P99, P100: Conn_01x01_Pin; PinHeader_1x01_P1.00mm_Vertical; not fitted
R4: 330; R_0603_1608Metric

Connections:
/CC_N_D_CC: Daughter_Card_PIN1.168, MOSbius_V1.67 (CC_N_D_CC), P67.1; also elsewhere on the board
/CC_N_D_CS: Daughter_Card_PIN1.166, MOSbius_V1.68 (CC_N_D_CS), P68.1; also elsewhere on the board
/CC_N_G_CC: Daughter_Card_PIN1.172, MOSbius_V1.65 (CC_N_G_CC), P65.1; also elsewhere on the board
/CC_N_G_CS: Daughter_Card_PIN1.170, MOSbius_V1.66 (CC_N_G_CS), P66.1; also elsewhere on the board
/CC_P_D_CC: Daughter_Card_PIN1.174, MOSbius_V1.64 (CC_P_D_CC), P64.1; also elsewhere on the board
/CC_P_D_CS: Daughter_Card_PIN1.176, MOSbius_V1.63 (CC_P_D_CS), P63.1; also elsewhere on the board
/CC_P_G_CC: Daughter_Card_PIN1.178, MOSbius_V1.62 (CC_P_G_CC), P62.1; also elsewhere on the board
/CC_P_G_CS: Daughter_Card_PIN1.180, MOSbius_V1.61 (CC_P_G_CS), P61.1; also elsewhere on the board
/CLK: Daughter_Card_PIN1.5, MOSbius_V1.3 (CLK), P3.1; also elsewhere on the board
/DATA_SBUS6: Daughter_Card_PIN1.7, MOSbius_V1.4 (DATA_SBUS6), P4.1; also elsewhere on the board
/DCC1_N_D_L_CC: Daughter_Card_PIN1.189, MOSbius_V1.45 (DCC1_N_D_L_CC), P45.1; also elsewhere on the board
/DCC1_N_D_L_CS: Daughter_Card_PIN1.191, MOSbius_V1.46 (DCC1_N_D_L_CS), P46.1; also elsewhere on the board
/DCC1_N_D_R_CC: Daughter_Card_PIN1.193, MOSbius_V1.47 (DCC1_N_D_R_CC), P47.1; also elsewhere on the board
/DCC1_N_D_R_CS: Daughter_Card_PIN1.195, MOSbius_V1.48 (DCC1_N_D_R_CS), P48.1; also elsewhere on the board
/DCC1_N_G_L_CC: Daughter_Card_PIN1.181, MOSbius_V1.41 (DCC1_N_G_L_CC), P41.1; also elsewhere on the board
/DCC1_N_G_L_CS: Daughter_Card_PIN1.183, MOSbius_V1.42 (DCC1_N_G_L_CS), P42.1; also elsewhere on the board
/DCC1_N_G_R_CC: Daughter_Card_PIN1.185, MOSbius_V1.43 (DCC1_N_G_R_CC), P43.1; also elsewhere on the board
/DCC1_N_G_R_CS: Daughter_Card_PIN1.187, MOSbius_V1.44 (DCC1_N_G_R_CS), P44.1; also elsewhere on the board
/DCC1_P_D_L_CC: Daughter_Card_PIN1.22, MOSbius_V1.90 (DCC1_P_D_L_CC), P90.1; also elsewhere on the board
/DCC1_P_D_L_CS: Daughter_Card_PIN1.24, MOSbius_V1.89 (DCC1_P_D_L_CS), P89.1; also elsewhere on the board
/DCC1_P_D_R_CC: Daughter_Card_PIN1.18, MOSbius_V1.92 (DCC1_P_D_R_CC), P92.1; also elsewhere on the board
/DCC1_P_D_R_CS: Daughter_Card_PIN1.20, MOSbius_V1.91 (DCC1_P_D_R_CS), P91.1; also elsewhere on the board
/DCC1_P_G_L_CC: Daughter_Card_PIN1.30, MOSbius_V1.86 (DCC1_P_G_L_CC), P86.1; also elsewhere on the board
/DCC1_P_G_L_CS: Daughter_Card_PIN1.32, MOSbius_V1.85 (DCC1_P_G_L_CS), P85.1; also elsewhere on the board
/DCC1_P_G_R_CC: Daughter_Card_PIN1.26, MOSbius_V1.88 (DCC1_P_G_R_CC), P88.1; also elsewhere on the board
/DCC1_P_G_R_CS: Daughter_Card_PIN1.28, MOSbius_V1.87 (DCC1_P_G_R_CS), P87.1; also elsewhere on the board
/DCC2_N_D_L_CC: Daughter_Card_PIN1.173, MOSbius_V1.37 (DCC2_N_D_L_CC), P37.1; also elsewhere on the board
/DCC2_N_D_L_CS: Daughter_Card_PIN1.175, MOSbius_V1.38 (DCC2_N_D_L_CS), P38.1; also elsewhere on the board
/DCC2_N_D_R_CC: Daughter_Card_PIN1.177, MOSbius_V1.39 (DCC2_N_D_R_CC), P39.1; also elsewhere on the board
/DCC2_N_D_R_CS: Daughter_Card_PIN1.179, MOSbius_V1.40 (DCC2_N_D_R_CS), P40.1; also elsewhere on the board
/DCC2_N_G_L_CC: Daughter_Card_PIN1.165, MOSbius_V1.33 (DCC2_N_G_L_CC), P33.1; also elsewhere on the board
/DCC2_N_G_L_CS: Daughter_Card_PIN1.167, MOSbius_V1.34 (DCC2_N_G_L_CS), P34.1; also elsewhere on the board
/DCC2_N_G_R_CC: Daughter_Card_PIN1.169, MOSbius_V1.35 (DCC2_N_G_R_CC), P35.1; also elsewhere on the board
/DCC2_N_G_R_CS: Daughter_Card_PIN1.171, MOSbius_V1.36 (DCC2_N_G_R_CS), P36.1; also elsewhere on the board
/DCC2_P_D_L_CC: Daughter_Card_PIN1.38, MOSbius_V1.82 (DCC2_P_D_L_CC), P82.1; also elsewhere on the board
/DCC2_P_D_L_CS: Daughter_Card_PIN1.40, MOSbius_V1.81 (DCC2_P_D_L_CS), P81.1; also elsewhere on the board
/DCC2_P_D_R_CC: Daughter_Card_PIN1.34, MOSbius_V1.84 (DCC2_P_D_R_CC), P84.1; also elsewhere on the board
/DCC2_P_D_R_CS: Daughter_Card_PIN1.36, MOSbius_V1.83 (DCC2_P_D_R_CS), P83.1; also elsewhere on the board
/DCC2_P_G_L_CC: Daughter_Card_PIN1.46, MOSbius_V1.78 (DCC2_P_G_L_CC), P78.1; also elsewhere on the board
/DCC2_P_G_L_CS: Daughter_Card_PIN1.48, MOSbius_V1.77 (DCC2_P_G_L_CS), P77.1; also elsewhere on the board
/DCC2_P_G_R_CC: Daughter_Card_PIN1.42, MOSbius_V1.80 (DCC2_P_G_R_CC), P80.1; also elsewhere on the board
/DCC2_P_G_R_CS: Daughter_Card_PIN1.44, MOSbius_V1.79 (DCC2_P_G_R_CS), P79.1; also elsewhere on the board
/DCC3_N_D_L_CC: Daughter_Card_PIN1.41, MOSbius_V1.21 (DCC3_N_D_L_CC), P21.1; also elsewhere on the board
/DCC3_N_D_L_CS: Daughter_Card_PIN1.43, MOSbius_V1.22 (DCC3_N_D_L_CS), P22.1; also elsewhere on the board
/DCC3_N_D_R_CC: Daughter_Card_PIN1.45, MOSbius_V1.23 (DCC3_N_D_R_CC), P23.1; also elsewhere on the board
/DCC3_N_D_R_CS: Daughter_Card_PIN1.47, MOSbius_V1.24 (DCC3_N_D_R_CS), P24.1; also elsewhere on the board
/DCC3_N_G_L_CC: Daughter_Card_PIN1.33, MOSbius_V1.17 (DCC3_N_G_L_CC), P17.1; also elsewhere on the board
/DCC3_N_G_L_CS: Daughter_Card_PIN1.35, MOSbius_V1.18 (DCC3_N_G_L_CS), P18.1; also elsewhere on the board
/DCC3_N_G_R_CC: Daughter_Card_PIN1.37, MOSbius_V1.19 (DCC3_N_G_R_CC), P19.1; also elsewhere on the board
/DCC3_N_G_R_CS: Daughter_Card_PIN1.39, MOSbius_V1.20 (DCC3_N_G_R_CS), P20.1; also elsewhere on the board
/DCC3_P_D_L_CC: Daughter_Card_PIN1.154, MOSbius_V1.74 (DCC3_P_D_L_CC), P74.1; also elsewhere on the board
/DCC3_P_D_L_CS: Daughter_Card_PIN1.156, MOSbius_V1.73 (DCC3_P_D_L_CS), P73.1; also elsewhere on the board
/DCC3_P_D_R_CC: Daughter_Card_PIN1.50, MOSbius_V1.76 (DCC3_P_D_R_CC), P76.1; also elsewhere on the board
/DCC3_P_D_R_CS: Daughter_Card_PIN1.152, MOSbius_V1.75 (DCC3_P_D_R_CS), P75.1; also elsewhere on the board
/DCC3_P_G_L_CC: Daughter_Card_PIN1.162, MOSbius_V1.70 (DCC3_P_G_L_CC), P70.1; also elsewhere on the board
/DCC3_P_G_L_CS: Daughter_Card_PIN1.164, MOSbius_V1.69 (DCC3_P_G_L_CS), P69.1; also elsewhere on the board
/DCC3_P_G_R_CC: Daughter_Card_PIN1.158, MOSbius_V1.72 (DCC3_P_G_R_CC), P72.1; also elsewhere on the board
/DCC3_P_G_R_CS: Daughter_Card_PIN1.160, MOSbius_V1.71 (DCC3_P_G_R_CS), P71.1; also elsewhere on the board
/DCC4_N_D_L_CC: Daughter_Card_PIN1.57, MOSbius_V1.29 (DCC4_N_D_L_CC), P29.1; also elsewhere on the board
/DCC4_N_D_L_CS: Daughter_Card_PIN1.59, MOSbius_V1.30 (DCC4_N_D_L_CS), P30.1; also elsewhere on the board
/DCC4_N_D_R_CC: Daughter_Card_PIN1.161, MOSbius_V1.31 (DCC4_N_D_R_CC), P31.1; also elsewhere on the board
/DCC4_N_D_R_CS: Daughter_Card_PIN1.163, MOSbius_V1.32 (DCC4_N_D_R_CS), P32.1; also elsewhere on the board
/DCC4_N_G_L_CC: Daughter_Card_PIN1.49, MOSbius_V1.25 (DCC4_N_G_L_CC), P25.1; also elsewhere on the board
/DCC4_N_G_L_CS: Daughter_Card_PIN1.51, MOSbius_V1.26 (DCC4_N_G_L_CS), P26.1; also elsewhere on the board
/DCC4_N_G_R_CC: Daughter_Card_PIN1.53, MOSbius_V1.27 (DCC4_N_G_R_CC), P27.1; also elsewhere on the board
/DCC4_N_G_R_CS: Daughter_Card_PIN1.55, MOSbius_V1.28 (DCC4_N_G_R_CS), P28.1; also elsewhere on the board
/DCC4_P_D_L_CC: Daughter_Card_PIN1.6, MOSbius_V1.98 (DCC4_P_D_L_CC), P98.1; also elsewhere on the board
/DCC4_P_D_L_CS: Daughter_Card_PIN1.8, MOSbius_V1.97 (DCC4_P_D_L_CS), P97.1; also elsewhere on the board
/DCC4_P_D_R_CC: Daughter_Card_PIN1.2, MOSbius_V1.100 (DCC4_P_D_R_CC), P100.1; also elsewhere on the board
/DCC4_P_D_R_CS: Daughter_Card_PIN1.4, MOSbius_V1.99 (DCC4_P_D_R_CS), P99.1; also elsewhere on the board
/DCC4_P_G_L_CC: Daughter_Card_PIN1.14, MOSbius_V1.94 (DCC4_P_G_L_CC), P94.1; also elsewhere on the board
/DCC4_P_G_L_CS: Daughter_Card_PIN1.16, MOSbius_V1.93 (DCC4_P_G_L_CS), P93.1; also elsewhere on the board
/DCC4_P_G_R_CC: Daughter_Card_PIN1.10, MOSbius_V1.96 (DCC4_P_G_R_CC), P96.1; also elsewhere on the board
/DCC4_P_G_R_CS: Daughter_Card_PIN1.12, MOSbius_V1.95 (DCC4_P_G_R_CS), P95.1; also elsewhere on the board
/DINV1_INN_L: Daughter_Card_PIN1.190, MOSbius_V1.56 (DINV1_INN_L), P56.1; also elsewhere on the board
/DINV1_INN_R: Daughter_Card_PIN1.184, MOSbius_V1.59 (DINV1_INN_R), P59.1; also elsewhere on the board
/DINV1_INP_L: Daughter_Card_PIN1.192, MOSbius_V1.55 (DINV1_INP_L), P55.1; also elsewhere on the board
/DINV1_INP_R: Daughter_Card_PIN1.186, MOSbius_V1.58 (DINV1_INP_R), P58.1; also elsewhere on the board
/DINV1_OUT_L: Daughter_Card_PIN1.188, MOSbius_V1.57 (DINV1_OUT_L), P57.1; also elsewhere on the board
/DINV1_OUT_R: Daughter_Card_PIN1.182, MOSbius_V1.60 (DINV1_OUT_R), P60.1; also elsewhere on the board
/DINV2_INN_L: Daughter_Card_PIN1.199, MOSbius_V1.50 (DINV2_INN_L), P50.1; also elsewhere on the board
/DINV2_INN_R: Daughter_Card_PIN1.196, MOSbius_V1.53 (DINV2_INN_R), P53.1; also elsewhere on the board
/DINV2_INP_L: Daughter_Card_PIN1.197, MOSbius_V1.49 (DINV2_INP_L), P49.1; also elsewhere on the board
/DINV2_INP_R: Daughter_Card_PIN1.198, MOSbius_V1.52 (DINV2_INP_R), P52.1; also elsewhere on the board
/DINV2_OUT_L: Daughter_Card_PIN1.200, MOSbius_V1.51 (DINV2_OUT_L), P51.1; also elsewhere on the board
/DINV2_OUT_R: Daughter_Card_PIN1.194, MOSbius_V1.54 (DINV2_OUT_R), P54.1; also elsewhere on the board
/EN: Daughter_Card_PIN1.3, MOSbius_V1.2 (EN); also elsewhere on the board
/OTA_N_INN: Daughter_Card_PIN1.29, MOSbius_V1.15 (OTA_N_INN), P15.1; also elsewhere on the board
/OTA_N_INP: Daughter_Card_PIN1.27, MOSbius_V1.14 (OTA_N_INP), P14.1; also elsewhere on the board
/OTA_N_OUT: Daughter_Card_PIN1.31, MOSbius_V1.16 (OTA_N_OUT), P16.1; also elsewhere on the board
/OTA_P_INN: Daughter_Card_PIN1.19, MOSbius_V1.10 (OTA_P_INN), P10.1; also elsewhere on the board
/OTA_P_INP: Daughter_Card_PIN1.21, MOSbius_V1.11 (OTA_P_INP), P11.1; also elsewhere on the board
/OTA_P_OUT: Daughter_Card_PIN1.23, MOSbius_V1.12 (OTA_P_OUT), P12.1; also elsewhere on the board
/SBUS1: Daughter_Card_PIN1.17, MOSbius_V1.9 (SBUS1), P9.1; also elsewhere on the board
/SBUS2: Daughter_Card_PIN1.15, MOSbius_V1.8 (SBUS2), P8.1; also elsewhere on the board
/SBUS3: Daughter_Card_PIN1.13, MOSbius_V1.7 (SBUS3), P7.1; also elsewhere on the board
/SBUS4: Daughter_Card_PIN1.11, MOSbius_V1.6 (SBUS4), P6.1; also elsewhere on the board
/SBUS5: Daughter_Card_PIN1.9, MOSbius_V1.5 (SBUS5), P5.1; also elsewhere on the board
GND: C1.2, C6.2, D2.1 (K), Daughter_Card_PIN1.1, Daughter_Card_PIN1.52, Daughter_Card_PIN1.54, Daughter_Card_PIN1.56, Daughter_Card_PIN1.58, Daughter_Card_PIN1.60, Daughter_Card_PIN1.61, Daughter_Card_PIN1.62, Daughter_Card_PIN1.63, Daughter_Card_PIN1.64, Daughter_Card_PIN1.65, Daughter_Card_PIN1.66, Daughter_Card_PIN1.67, Daughter_Card_PIN1.68, Daughter_Card_PIN1.69, Daughter_Card_PIN1.70, Daughter_Card_PIN1.71, Daughter_Card_PIN1.72, Daughter_Card_PIN1.73, Daughter_Card_PIN1.74, Daughter_Card_PIN1.75, Daughter_Card_PIN1.76, Daughter_Card_PIN1.77, Daughter_Card_PIN1.78, Daughter_Card_PIN1.79, Daughter_Card_PIN1.80, Daughter_Card_PIN1.81, Daughter_Card_PIN1.82, Daughter_Card_PIN1.83, Daughter_Card_PIN1.84, Daughter_Card_PIN1.85, Daughter_Card_PIN1.86, Daughter_Card_PIN1.87, Daughter_Card_PIN1.88, Daughter_Card_PIN1.89, Daughter_Card_PIN1.90, Daughter_Card_PIN1.91, Daughter_Card_PIN1.92, Daughter_Card_PIN1.93, Daughter_Card_PIN1.94, Daughter_Card_PIN1.95, Daughter_Card_PIN1.96, Daughter_Card_PIN1.97, Daughter_Card_PIN1.98, Daughter_Card_PIN1.99, Daughter_Card_PIN1.100, Daughter_Card_PIN1.101, Daughter_Card_PIN1.102, Daughter_Card_PIN1.103, Daughter_Card_PIN1.104, Daughter_Card_PIN1.105, Daughter_Card_PIN1.106, Daughter_Card_PIN1.107, Daughter_Card_PIN1.108, Daughter_Card_PIN1.109, Daughter_Card_PIN1.110, Daughter_Card_PIN1.111, Daughter_Card_PIN1.112, Daughter_Card_PIN1.113, Daughter_Card_PIN1.114, Daughter_Card_PIN1.115, Daughter_Card_PIN1.116, Daughter_Card_PIN1.117, Daughter_Card_PIN1.118, Daughter_Card_PIN1.119, Daughter_Card_PIN1.120, Daughter_Card_PIN1.121, Daughter_Card_PIN1.122, Daughter_Card_PIN1.123, Daughter_Card_PIN1.124, Daughter_Card_PIN1.125, Daughter_Card_PIN1.126, Daughter_Card_PIN1.127, Daughter_Card_PIN1.128, Daughter_Card_PIN1.129, Daughter_Card_PIN1.130, Daughter_Card_PIN1.131, Daughter_Card_PIN1.132, Daughter_Card_PIN1.133, Daughter_Card_PIN1.134, Daughter_Card_PIN1.135, Daughter_Card_PIN1.136, Daughter_Card_PIN1.137, Daughter_Card_PIN1.138, Daughter_Card_PIN1.139, Daughter_Card_PIN1.140, Daughter_Card_PIN1.141, Daughter_Card_PIN1.142, Daughter_Card_PIN1.143, Daughter_Card_PIN1.144, Daughter_Card_PIN1.145, Daughter_Card_PIN1.146, Daughter_Card_PIN1.147, Daughter_Card_PIN1.148, Daughter_Card_PIN1.149, Daughter_Card_PIN1.150, Daughter_Card_PIN1.151, Daughter_Card_PIN1.153, Daughter_Card_PIN1.155, Daughter_Card_PIN1.157, Daughter_Card_PIN1.159, MOSbius_V1.1 (VSS); also elsewhere on the board
unnamed: D2.2 (A), R4.2
VDD: C1.1, C6.1, Daughter_Card_PIN1.25, MOSbius_V1.13 (VDD), R4.1; also elsewhere on the board

Notes on the sheet:
headers are added around chip pins (redcross = DO NOT Populate)
Decaps for Daughter Card
Unused Pins are connected to GND
VDD and GND are from Mother Board, hence there is no output source for powers in daughter board

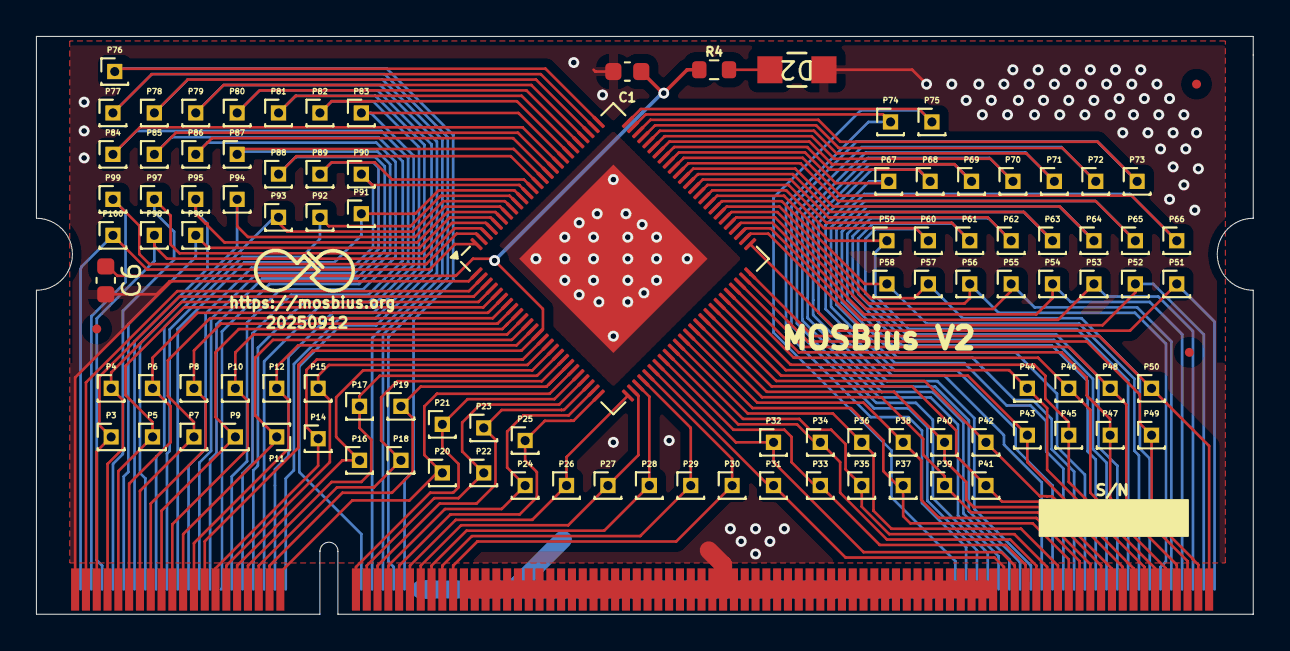
[picture p39: board Daughter_Card.kicad_pcb from above]

Board: 2 copper layers, 67.6 x 32.1 mm, 103 parts (0 on the bottom side), 101 nets.

Other parts of the board:
MOSbius_V2: MOSbius_V2; ArtInChip_QFN-100-1EP_12x12mm_P0.4mm_EP7.4x7.4mm

Their connections:
/CC_N_D_CC: MOSbius_V2.67 (CC_N_D_CC); also elsewhere on the board
/CC_N_D_CS: MOSbius_V2.68 (CC_N_D_CS); also elsewhere on the board
/CC_N_G_CC: MOSbius_V2.65 (CC_N_G_CC); also elsewhere on the board
/CC_N_G_CS: MOSbius_V2.66 (CC_N_G_CS); also elsewhere on the board
/CC_P_D_CC: MOSbius_V2.64 (CC_P_D_CC); also elsewhere on the board
/CC_P_D_CS: MOSbius_V2.63 (CC_P_D_CS); also elsewhere on the board
/CC_P_G_CC: MOSbius_V2.62 (CC_P_G_CC); also elsewhere on the board
/CC_P_G_CS: MOSbius_V2.61 (CC_P_G_CS); also elsewhere on the board
/CLK: MOSbius_V2.3 (CLK); also elsewhere on the board
/DATA_SBUS6: MOSbius_V2.4 (DATA_SBUS6); also elsewhere on the board
/DCC1_N_D_L_CC: MOSbius_V2.45 (DCC1_N_D_L_CC); also elsewhere on the board
/DCC1_N_D_L_CS: MOSbius_V2.46 (DCC1_N_D_L_CS); also elsewhere on the board
/DCC1_N_D_R_CC: MOSbius_V2.47 (DCC1_N_D_R_CC); also elsewhere on the board
/DCC1_N_D_R_CS: MOSbius_V2.48 (DCC1_N_D_R_CS); also elsewhere on the board
/DCC1_N_G_L_CC: MOSbius_V2.41 (DCC1_N_G_L_CC); also elsewhere on the board
/DCC1_N_G_L_CS: MOSbius_V2.42 (DCC1_N_G_L_CS); also elsewhere on the board
/DCC1_N_G_R_CC: MOSbius_V2.43 (DCC1_N_G_R_CC); also elsewhere on the board
/DCC1_N_G_R_CS: MOSbius_V2.44 (DCC1_N_G_R_CS); also elsewhere on the board
/DCC1_P_D_L_CC: MOSbius_V2.90 (DCC1_P_D_L_CC); also elsewhere on the board
/DCC1_P_D_L_CS: MOSbius_V2.89 (DCC1_P_D_L_CS); also elsewhere on the board
/DCC1_P_D_R_CC: MOSbius_V2.92 (DCC1_P_D_R_CC); also elsewhere on the board
/DCC1_P_D_R_CS: MOSbius_V2.91 (DCC1_P_D_R_CS); also elsewhere on the board
/DCC1_P_G_L_CC: MOSbius_V2.86 (DCC1_P_G_L_CC); also elsewhere on the board
/DCC1_P_G_L_CS: MOSbius_V2.85 (DCC1_P_G_L_CS); also elsewhere on the board
/DCC1_P_G_R_CC: MOSbius_V2.88 (DCC1_P_G_R_CC); also elsewhere on the board
/DCC1_P_G_R_CS: MOSbius_V2.87 (DCC1_P_G_R_CS); also elsewhere on the board
/DCC2_N_D_L_CC: MOSbius_V2.37 (DCC2_N_D_L_CC); also elsewhere on the board
/DCC2_N_D_L_CS: MOSbius_V2.38 (DCC2_N_D_L_CS); also elsewhere on the board
/DCC2_N_D_R_CC: MOSbius_V2.39 (DCC2_N_D_R_CC); also elsewhere on the board
/DCC2_N_D_R_CS: MOSbius_V2.40 (DCC2_N_D_R_CS); also elsewhere on the board
/DCC2_N_G_L_CC: MOSbius_V2.33 (DCC2_N_G_L_CC); also elsewhere on the board
/DCC2_N_G_L_CS: MOSbius_V2.34 (DCC2_N_G_L_CS); also elsewhere on the board
/DCC2_N_G_R_CC: MOSbius_V2.35 (DCC2_N_G_R_CC); also elsewhere on the board
/DCC2_N_G_R_CS: MOSbius_V2.36 (DCC2_N_G_R_CS); also elsewhere on the board
/DCC2_P_D_L_CC: MOSbius_V2.82 (DCC2_P_D_L_CC); also elsewhere on the board
/DCC2_P_D_L_CS: MOSbius_V2.81 (DCC2_P_D_L_CS); also elsewhere on the board
/DCC2_P_D_R_CC: MOSbius_V2.84 (DCC2_P_D_R_CC); also elsewhere on the board
/DCC2_P_D_R_CS: MOSbius_V2.83 (DCC2_P_D_R_CS); also elsewhere on the board
/DCC2_P_G_L_CC: MOSbius_V2.78 (DCC2_P_G_L_CC); also elsewhere on the board
/DCC2_P_G_L_CS: MOSbius_V2.77 (DCC2_P_G_L_CS); also elsewhere on the board
/DCC2_P_G_R_CC: MOSbius_V2.80 (DCC2_P_G_R_CC); also elsewhere on the board
/DCC2_P_G_R_CS: MOSbius_V2.79 (DCC2_P_G_R_CS); also elsewhere on the board
/DCC3_N_D_L_CC: MOSbius_V2.21 (DCC3_N_D_L_CC); also elsewhere on the board
/DCC3_N_D_L_CS: MOSbius_V2.22 (DCC3_N_D_L_CS); also elsewhere on the board
/DCC3_N_D_R_CC: MOSbius_V2.23 (DCC3_N_D_R_CC); also elsewhere on the board
/DCC3_N_D_R_CS: MOSbius_V2.24 (DCC3_N_D_R_CS); also elsewhere on the board
/DCC3_N_G_L_CC: MOSbius_V2.17 (DCC3_N_G_L_CC); also elsewhere on the board
/DCC3_N_G_L_CS: MOSbius_V2.18 (DCC3_N_G_L_CS); also elsewhere on the board
/DCC3_N_G_R_CC: MOSbius_V2.19 (DCC3_N_G_R_CC); also elsewhere on the board
/DCC3_N_G_R_CS: MOSbius_V2.20 (DCC3_N_G_R_CS); also elsewhere on the board
/DCC3_P_D_L_CC: MOSbius_V2.74 (DCC3_P_D_L_CC); also elsewhere on the board
/DCC3_P_D_L_CS: MOSbius_V2.73 (DCC3_P_D_L_CS); also elsewhere on the board
/DCC3_P_D_R_CC: MOSbius_V2.76 (DCC3_P_D_R_CC); also elsewhere on the board
/DCC3_P_D_R_CS: MOSbius_V2.75 (DCC3_P_D_R_CS); also elsewhere on the board
/DCC3_P_G_L_CC: MOSbius_V2.70 (DCC3_P_G_L_CC); also elsewhere on the board
/DCC3_P_G_L_CS: MOSbius_V2.69 (DCC3_P_G_L_CS); also elsewhere on the board
/DCC3_P_G_R_CC: MOSbius_V2.72 (DCC3_P_G_R_CC); also elsewhere on the board
/DCC3_P_G_R_CS: MOSbius_V2.71 (DCC3_P_G_R_CS); also elsewhere on the board
/DCC4_N_D_L_CC: MOSbius_V2.29 (DCC4_N_D_L_CC); also elsewhere on the board
/DCC4_N_D_L_CS: MOSbius_V2.30 (DCC4_N_D_L_CS); also elsewhere on the board
/DCC4_N_D_R_CC: MOSbius_V2.31 (DCC4_N_D_R_CC); also elsewhere on the board
/DCC4_N_D_R_CS: MOSbius_V2.32 (DCC4_N_D_R_CS); also elsewhere on the board
/DCC4_N_G_L_CC: MOSbius_V2.25 (DCC4_N_G_L_CC); also elsewhere on the board
/DCC4_N_G_L_CS: MOSbius_V2.26 (DCC4_N_G_L_CS); also elsewhere on the board
/DCC4_N_G_R_CC: MOSbius_V2.27 (DCC4_N_G_R_CC); also elsewhere on the board
/DCC4_N_G_R_CS: MOSbius_V2.28 (DCC4_N_G_R_CS); also elsewhere on the board
/DCC4_P_D_L_CC: MOSbius_V2.98 (DCC4_P_D_L_CC); also elsewhere on the board
/DCC4_P_D_L_CS: MOSbius_V2.97 (DCC4_P_D_L_CS); also elsewhere on the board
/DCC4_P_D_R_CC: MOSbius_V2.100 (DCC4_P_D_R_CC); also elsewhere on the board
/DCC4_P_D_R_CS: MOSbius_V2.99 (DCC4_P_D_R_CS); also elsewhere on the board
/DCC4_P_G_L_CC: MOSbius_V2.94 (DCC4_P_G_L_CC); also elsewhere on the board
/DCC4_P_G_L_CS: MOSbius_V2.93 (DCC4_P_G_L_CS); also elsewhere on the board
/DCC4_P_G_R_CC: MOSbius_V2.96 (DCC4_P_G_R_CC); also elsewhere on the board
/DCC4_P_G_R_CS: MOSbius_V2.95 (DCC4_P_G_R_CS); also elsewhere on the board
/DINV1_INN_L: MOSbius_V2.56 (DINV1_INN_L); also elsewhere on the board
/DINV1_INN_R: MOSbius_V2.59 (DINV1_INN_R); also elsewhere on the board
/DINV1_INP_L: MOSbius_V2.55 (DINV1_INP_L); also elsewhere on the board
/DINV1_INP_R: MOSbius_V2.58 (DINV1_INP_R); also elsewhere on the board
/DINV1_OUT_L: MOSbius_V2.57 (DINV1_OUT_L); also elsewhere on the board
/DINV1_OUT_R: MOSbius_V2.60 (DINV1_OUT_R); also elsewhere on the board
/DINV2_INN_L: MOSbius_V2.50 (DINV2_INN_L); also elsewhere on the board
/DINV2_INN_R: MOSbius_V2.53 (DINV2_INN_R); also elsewhere on the board
/DINV2_INP_L: MOSbius_V2.49 (DINV2_INP_L); also elsewhere on the board
/DINV2_INP_R: MOSbius_V2.52 (DINV2_INP_R); also elsewhere on the board
/DINV2_OUT_L: MOSbius_V2.51 (DINV2_OUT_L); also elsewhere on the board
/DINV2_OUT_R: MOSbius_V2.54 (DINV2_OUT_R); also elsewhere on the board
/EN: MOSbius_V2.2 (EN); also elsewhere on the board
/OTA_N_INN: MOSbius_V2.15 (OTA_N_INN); also elsewhere on the board
/OTA_N_INP: MOSbius_V2.14 (OTA_N_INP); also elsewhere on the board
/OTA_N_OUT: MOSbius_V2.16 (OTA_N_OUT); also elsewhere on the board
/OTA_P_INN: MOSbius_V2.10 (OTA_P_INN); also elsewhere on the board
/OTA_P_INP: MOSbius_V2.11 (OTA_P_INP); also elsewhere on the board
/OTA_P_OUT: MOSbius_V2.12 (OTA_P_OUT); also elsewhere on the board
/SBUS1: MOSbius_V2.9 (SBUS1); also elsewhere on the board
/SBUS2: MOSbius_V2.8 (SBUS2); also elsewhere on the board
/SBUS3: MOSbius_V2.7 (SBUS3); also elsewhere on the board
/SBUS4: MOSbius_V2.6 (SBUS4); also elsewhere on the board
/SBUS5: MOSbius_V2.5 (SBUS5); also elsewhere on the board
GND: MOSbius_V2.1 (VSS); also elsewhere on the board
VDD: MOSbius_V2.13 (VDD); also elsewhere on the board
