xL1n/MOSBius_V2_PCB/(commit log)

2025-09-01 Mother Board and Daughter Board upload on 1/9/2025
    [5-1746530-4.SchLib, 517465304.PcbLib, 517465304.psm, AD8542ARMZ-REEL.SchLib, AD8542ARMZ-REEL.stp, Daughter_Card.kicad_pcb, Daughter_Card.kicad_sch, EDI2CAP.CFG]
2025-09-14 update in 0912
    [Daughter_Card.kicad_pcb, Daughter_Card.kicad_sch, Mock_Test.kicad_pcb, Mock_Test.kicad_sch, Mother_Card.kicad_pcb, Mother_Card.kicad_sch]
2026-03-12 0311_2026 XP update - mainly in RPI board
    [3314J-1-253E.step, DS4404N__T_R.step, MOSbius_DevKit_v5.kicad_pcb, MOSbius_DevKit_v5.kicad_sch, Pico.skp, Test.kicad_pcb, Test.kicad_sch, combined_board.kicad_pcb]
